JamPsym/letki/archive/hw/ledkiv3.1-baseline-20261015/README.md

# Letki v3.1 — frozen accepted baseline

The user accepted this design as v3.1 on 15 October 2026.
Read [the snapshot record](BASELINE.txt) and [exact identities](baseline.json).
Native CAD and local libraries/models are preserved here; the checked package
is under `exports/prototype/`. Physical qualification remains pending.

Continue human/agent work in the [canonical project](../../../hw/ledkiv3.1/README.md).
This directory is a frozen reference. Preserve its sources and generated package.
