JamPsym/letki/archive/hw/ledkiv3.2-unrouted-20261017/README.txt

Saved checked UNROUTED v3.2 checkpoint, 2026-10-17.
Open hw/ledkiv3.2/ledkiv3_2.kicad_pro for potential human routing.
159 footprints,4layers,307opens; no tracks/vias/zones.
All authored CAD/library/model files are preserved. MANIFEST.json binds them.
Copy the complete folder before routing; keep this checkpoint unchanged.
The live agent-routed successor will remain /home/pies/letki/hw/ledkiv3.2/.
This checkpoint is saved disk state, not a capture of unsaved editor changes.
No fabrication or physical qualification is implied.
