JamPsym/letki/archive/hw/ledkiv4-pre-tme-20261012/ARCHIVE.md

# V4 before the TME redesign

Source snapshot taken on 2026-10-12 before the v4.1 iteration. The original
README and local libraries/mechanical models are preserved. File hashes are
in `snapshot-manifest.json`; design, parts and shipping notes are copied beside
the CAD. This was an unfabricated reviewed prototype candidate, not physically
qualified production hardware. Do not port v4.1 changes into this snapshot.
