JamPsym/letki/docs/tme-next-revision-parts.csv

tme_symbol | mpn | role | population | quantity_per_population | package | currency | minimum | multiple | stock_snapshot | source_age | supplier_url | review_note | status
74HCT238D.653 | 74HCT238D,653 | column decoder | TILE | 1 | SO16 1.27mm | USD | 1 | 1 | 2169 | 4 months; catalogue, not live cart | https://www.tme.eu/pl/katalog/dekodery-multipleksery-przelaczniki_113424/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 | Active-high HCT; needs new SO16 footprint. Confirm stock/lead time. TI CD74HCT238M96 is alternative, not priced. | PRELIMINARY_NEW_REVISION_NOT_V4_ORDER
SN74HCT244PWR | SN74HCT244PWR | row source buffer | TILE | 1 | TSSOP20 0.65mm | USD | 1 | 1 | 2919 | 3 months | https://www.tme.eu/en/details/sn74hct244pwr/buffers-transceivers-drivers/texas-instruments/ | Retain v4 driver and 1.2k current budget; 70mA absolute supply rating is not operating target. | PRELIMINARY_NEW_REVISION_NOT_V4_ORDER
74LVC2G34GW.125 | 74LVC2G34GW,125 | UART dual buffer | TILE | 1 | SOT363-2 6 pins 0.65mm | USD | 1 | 1 | 931 | 2 months; Norway locale USD | https://www.tme.eu/no/en/details/74lvc2g34gw.125/buffers-transceivers-drivers/nexperia/74lvc2g34gw-125/ | New footprint; two always-enabled noninverting buffers; 5.5V tolerant inputs, Ioff; verify UART edge rise/fall conditions with series R. | PRELIMINARY_NEW_REVISION_NOT_V4_ORDER
DMG2302UK-7 | DMG2302UK-7 | column sink MOSFET | TILE | 8 | SOT23 G1 S2 D3 | PLN | 1 | 1 | 7155 | 1 day | https://www.tme.eu/pl/details/dmg2302uk-7/tranzystory-z-kanalem-n-smd/diodes-incorporated/ | 120mOhm maximum at Vgs2.5V/25C. Typical gate charge1.4nC; switching/temperature still need prototype measurements. | PRELIMINARY_NEW_REVISION_NOT_V4_ORDER
MIC5504-3.3YM5-TR | MIC5504-3.3YM5-TR | 3.3V regulator | TILE | 1 | SOT23-5 | PLN | 1 | 1 | 8300 | 1 month | https://www.tme.eu/pl/details/mic5504-3.3ym5-tr/stabilizatory-napiecia-nieregulowane-ldo/microchip-technology/ | New footprint:1IN2GND3EN4NC5OUT; tie EN to IN; input2.5-5.5V; effective output capacitance>=1uF; no probe powering of rail. | PRELIMINARY_NEW_REVISION_NOT_V4_ORDER
CC0603KRX7R9BB104 | CC0603KRX7R9BB104 | 100nF bypass | TILE | 4 | 0603 50V X7R 10% | PLN | 1 | 1 | 239302 | today | https://www.tme.eu/pl/details/cc0603krx7r9bb104/kondensatory-mlcc-smd/yageo/ | Same part as v4; add one more for USB head through head_extra quantity. | PRELIMINARY_NEW_REVISION_NOT_V4_ORDER
CL21B475KAFNNNE | CL21B475KAFNNNE | LDO input/output capacitor | TILE | 2 | 0805 4.7uF 25V X7R 10% | PLN | 10 | 1 | 64111 | 1 day | https://www.tme.eu/pl/details/cl21b475kafnnne/kondensatory-mlcc-smd/samsung/ | Manufacturer mass-production status verified; part-specific DC bias/effective capacitance remains a gate. Alternative2.2uF Murata is not included here. | PRELIMINARY_NEW_REVISION_NOT_V4_ORDER
TACT-64K-F | TACT-64K-F | buttons | TILE | 2 | THT 6x6mm | PLN | 10 | 10 | 4740 | 5 months | https://www.tme.eu/pl/details/tact-64k-f/mikroprzelaczniki-tact/ninigi/ | New footprint; keep THT legs outside LED field; confirm actuation access and carrier clearance. SMT B3U-1000P is smaller and more expensive. | PRELIMINARY_NEW_REVISION_NOT_V4_ORDER
SMD0805-1K2-1% | 0805S8F1201T5E | row resistors | TILE | 8 | 0805 1.2k 1% 125mW 100ppm/C | PLN | 100 | 100 | 73080 | 1 week | https://www.tme.eu/pl/details/smd0805-1k2-1%25/rezystory-smd/royalohm/0805s8f1201t5e/ | Cut-tape catalogue symbol; rendered price rounded to0.01PLN. Confirm exact tier totals. Original W-series full-reel listings may have5000-piece minimum. | PRELIMINARY_NEW_REVISION_NOT_V4_ORDER
SMD0805-100K-1% | 0805S8F1003T5E | idle pulls | TILE | 2 | 0805 100k 1% | PLN | 100 | 100 | 1228463 | 1 week | https://www.tme.eu/pl/details/smd0805-100k-1%25/rezystory-smd/royalohm/0805s8f1003t5e/ | Cut-tape catalogue symbol; rendered price rounded to0.01PLN. Confirm exact tier totals. Original W-series full-reel listings may have5000-piece minimum. | PRELIMINARY_NEW_REVISION_NOT_V4_ORDER
SMD0805-2K2-1% | 0805S8F2201T5E | selectable I2C pulls | TILE | 2 | 0805 2.2k 1% | PLN | 100 | 100 | 884087 | 1 week | https://www.tme.eu/pl/details/smd0805-2k2-1%25/rezystory-smd/royalohm/0805s8f2201t5e/ | Cut-tape catalogue symbol; rendered price rounded to0.01PLN. Confirm exact tier totals. Original W-series full-reel listings may have5000-piece minimum. | PRELIMINARY_NEW_REVISION_NOT_V4_ORDER
SMD0603-100K-1% | 0603SAF1003T5E | startup pulls | TILE | 13 | 0603 100k 1% | PLN | 100 | 100 | 376386 | 1 month | https://www.tme.eu/pl/details/smd0603-100k-1%25/rezystory-smd/royalohm/0603saf1003t5e/ | Cut-tape catalogue symbol; rendered price rounded to0.01PLN. Confirm exact tier totals. Original W-series full-reel listings may have5000-piece minimum. | PRELIMINARY_NEW_REVISION_NOT_V4_ORDER
SMD0603-2K2-1% | 0603SAF2201T5E | UART series resistors | TILE | 2 | 0603 2.2k 1% | PLN | 100 | 100 | 586191 | 1 month | https://www.tme.eu/pl/details/smd0603-2k2-1%25/rezystory-smd/royalohm/0603saf2201t5e/ | Cut-tape catalogue symbol; rendered price rounded to0.01PLN. Confirm exact tier totals. Original W-series full-reel listings may have5000-piece minimum. | PRELIMINARY_NEW_REVISION_NOT_V4_ORDER
SMD0603-5K1-1% | 0603SAF5101T5E | USB CC pulls | HEAD_ONLY | 2 | 0603 5.1k 1% | PLN | 100 | 100 |  | 8 months; stock unconfirmed | https://www.tme.eu/pl/details/smd0603-5k1-1%25/rezystory-smd/royalohm/0603saf5101t5e/ | Cut-tape catalogue symbol; rendered price rounded to0.01PLN. Confirm exact tier totals. Original W-series full-reel listings may have5000-piece minimum. | PRELIMINARY_NEW_REVISION_NOT_V4_ORDER
SMD0603-33K-1% | 0603SAF3302T5E | USB current limit resistor | HEAD_ONLY | 1 | 0603 33k 1% 100ppm/C | PLN | 100 | 100 | 103499 | 2 months | https://www.tme.eu/pl/details/smd0603-33k-1%25/rezystory-smd/royalohm/0603saf3302t5e/ | Cut-tape catalogue symbol; rendered price rounded to0.01PLN. Confirm exact tier totals. Original W-series full-reel listings may have5000-piece minimum. | PRELIMINARY_NEW_REVISION_NOT_V4_ORDER
USB4216-03-A | USB4216-03-A | USB-C head connector | HEAD_ONLY | 1 | 16pin SMT; new manufacturer footprint | PLN | 1 | 1 | 1374 | 1 month | https://www.tme.eu/pl/details/usb4216-03-a/zlacza-usb-i-ieee1394/gct/ | New lands/anchors/edge clearance; independent5.1k on each CC; no USB data or PD. One powered USB head per chain. | PRELIMINARY_NEW_REVISION_NOT_V4_ORDER
TPS2553DBVR | TPS2553DBVR | USB input current limiter | HEAD_ONLY | 1 | SOT23-6 | PLN | 1 | 1 | 5 | 1 week | https://www.tme.eu/pl/details/tps2553dbvr/power-switches-uklady-scalone/texas-instruments/ | Retain v4 head scheme and33k current setting; -1 is not automatic substitute. One head per estimate, not a20-board power qualification. | PRELIMINARY_NEW_REVISION_NOT_V4_ORDER
MX-53047-0310 | 530470310 | optional SWIO header | OPTIONAL_PER_TILE | 1 | PicoBlade3pin vertical THT | PLN | 1 | 1 | 2345 | 1 month | https://www.tme.eu/pl/details/mx-53047-0310/zlacza-sygnalowe-raster-1-25mm/molex/53047-0310/ | Optional one/tile; retain bare pads. REF3.3V is not programmer power input. Cable priced separately. | PRELIMINARY_NEW_REVISION_NOT_V4_ORDER
