JamPsym/letki/hw/ledkiv2/dyfuzor/PCB ledkiv2.FCStd

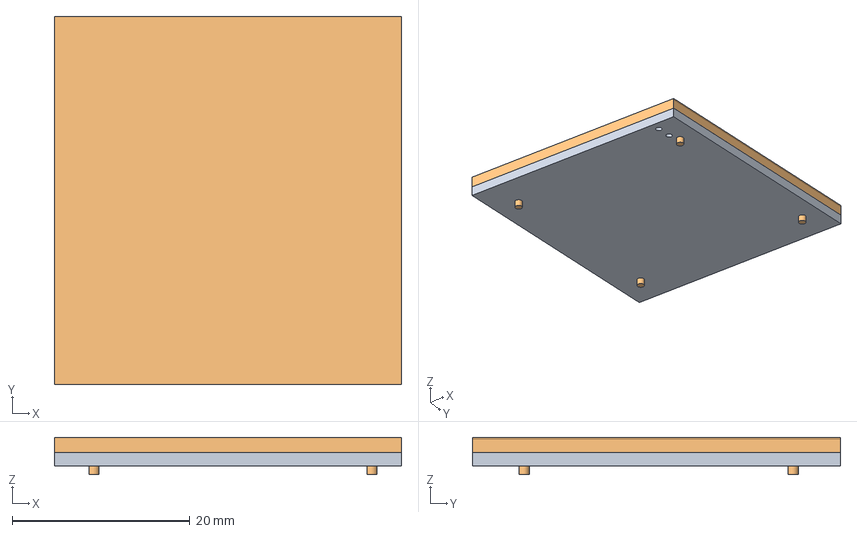
[picture p1: CAD file, 2025-11-01]
hw/ledkiv2/dyfuzor/PCB ledkiv2.FCStd
39.0 x 41.4 x 4.20 mm
LED_0805_2012Metric
LED_0805_2012Metric001
LED_0805_2012Metric002
LED_0805_2012Metric003
LED_0805_2012Metric004
LED_0805_2012Metric005
LED_0805_2012Metric006
LED_0805_2012Metric007
LED_0805_2012Metric008
LED_0805_2012Metric009
LED_0805_2012Metric010
LED_0805_2012Metric011
LED_0805_2012Metric012
LED_0805_2012Metric013
LED_0805_2012Metric014
LED_0805_2012Metric015
LED_0805_2012Metric016
LED_0805_2012Metric017
LED_0805_2012Metric018
LED_0805_2012Metric019
LED_0805_2012Metric020
LED_0805_2012Metric021
LED_0805_2012Metric022
LED_0805_2012Metric023
LED_0805_2012Metric024
LED_0805_2012Metric025
LED_0805_2012Metric026
LED_0805_2012Metric027
LED_0805_2012Metric028
LED_0805_2012Metric029
LED_0805_2012Metric030
LED_0805_2012Metric031
LED_0805_2012Metric032
LED_0805_2012Metric033
LED_0805_2012Metric034
LED_0805_2012Metric035
LED_0805_2012Metric036
LED_0805_2012Metric037
LED_0805_2012Metric038
LED_0805_2012Metric039
LED_0805_2012Metric040
LED_0805_2012Metric041
LED_0805_2012Metric042
LED_0805_2012Metric043
LED_0805_2012Metric044
LED_0805_2012Metric045
LED_0805_2012Metric046
LED_0805_2012Metric047
LED_0805_2012Metric048
LED_0805_2012Metric049
LED_0805_2012Metric050
LED_0805_2012Metric051
LED_0805_2012Metric052
LED_0805_2012Metric053
LED_0805_2012Metric054
LED_0805_2012Metric055
LED_0805_2012Metric056
LED_0805_2012Metric057
LED_0805_2012Metric058
LED_0805_2012Metric059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
