JamPsym/letki/hw/ledkiv4/mechanics/letkiv4-mechanics-1-tiles.FCStd

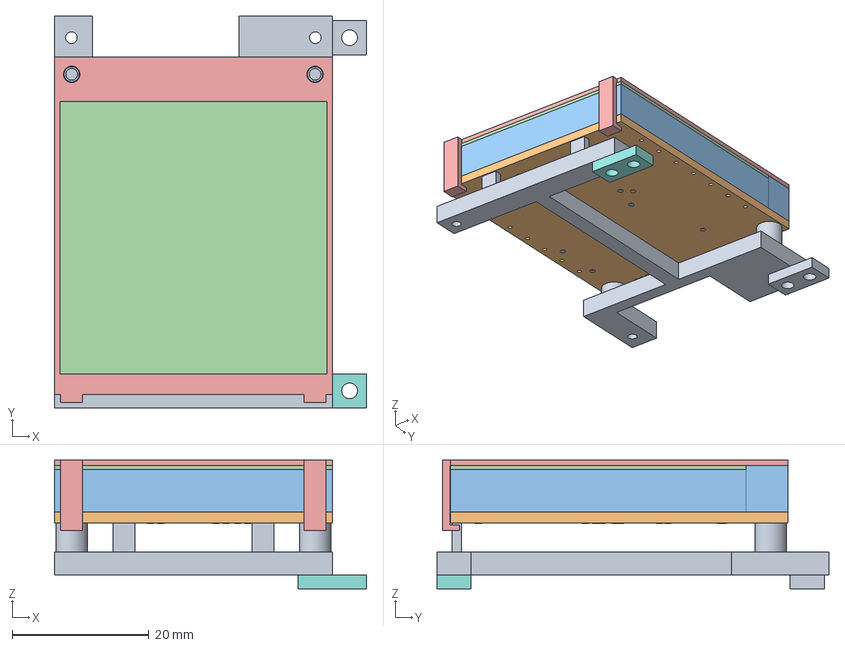
[picture p3: CAD file, 2026-10-18]
hw/ledkiv4/mechanics/letkiv4-mechanics-1-tiles.FCStd
45.6 x 57.3 x 18.8 mm
Carrier
PCB1
OpaqueGrid1
TranslucentFace1
FrontBezel1
TP1_Tile1
TP2_Tile1
TP3_Tile1
TP4_Tile1
TP5_Tile1
TP6_Tile1
TP7_Tile1
TP8_Tile1
TP9_Tile1
TP10_Tile1
SpliceTop
SpliceBottom
