JamPsym/letki/archive/hw/ledkiv4-flat-pads-20261012/mechanics/letkiv4-mechanics-4-tiles.FCStd

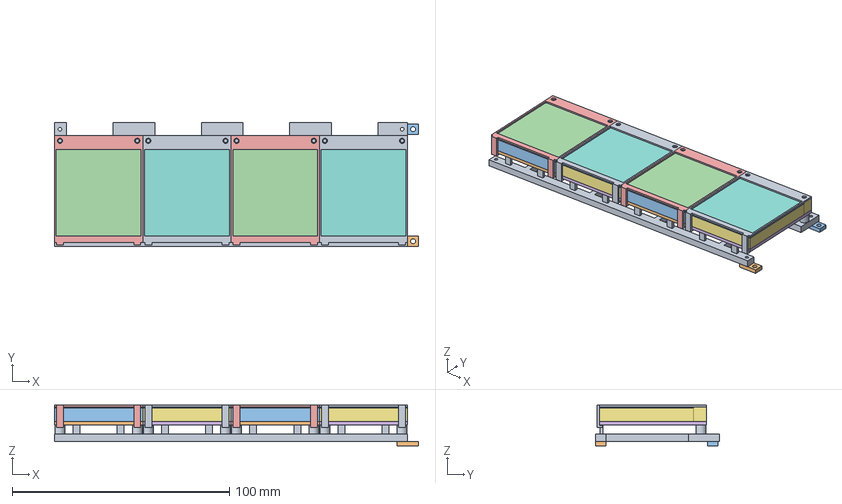
[picture p5: CAD file, 2026-10-18, an earlier design]
archive/hw/ledkiv4-flat-pads-20261012/mechanics/letkiv4-mechanics-4-tiles.FCStd
167.6 x 57.3 x 18.8 mm
Carrier
PCB1
OpaqueGrid1
TranslucentFace1
FrontBezel1
PCB2
OpaqueGrid2
TranslucentFace2
FrontBezel2
PCB3
OpaqueGrid3
TranslucentFace3
FrontBezel3
PCB4
OpaqueGrid4
TranslucentFace4
FrontBezel4
SpliceTop
SpliceBottom
