JamPsym/letki/archive/hw/ledkiv4-optical-initial/letkiv4-optical-prototype.FCStd

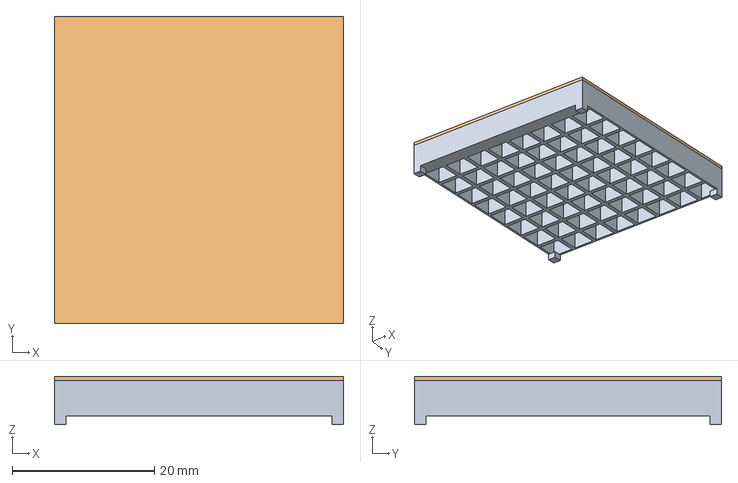
[picture p6: CAD file, 2026-10-18, an earlier design]
archive/hw/ledkiv4-optical-initial/letkiv4-optical-prototype.FCStd
40.6 x 43.2 x 6.80 mm
OpaqueGrid
TranslucentFace
