JamPsym/letki/archive/hw/ledkiv4-pre-tme-20261012/mechanics/letkiv4-mechanics-4-tiles.FCStd

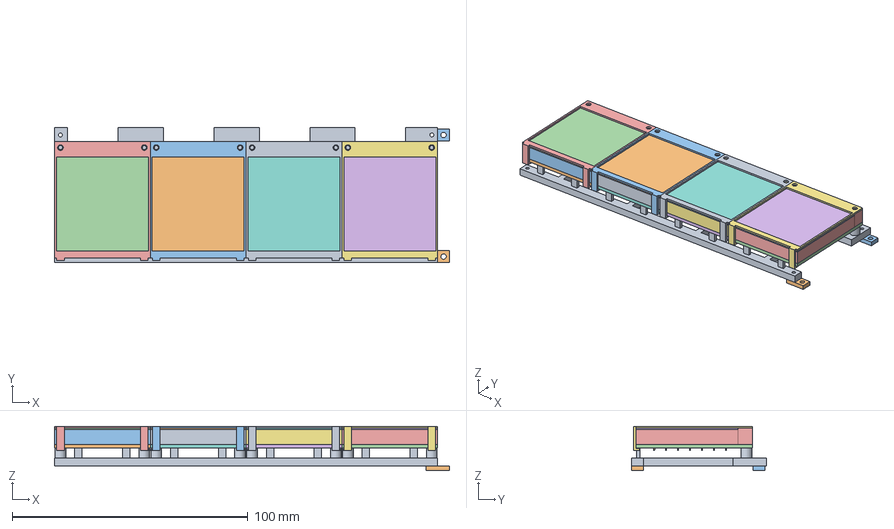
[picture p7: CAD file, 2026-10-18, an earlier design]
archive/hw/ledkiv4-pre-tme-20261012/mechanics/letkiv4-mechanics-4-tiles.FCStd
167.6 x 57.3 x 18.8 mm
Carrier
PCB1
OpaqueGrid1
TranslucentFace1
FrontBezel1
TP1_Tile1
TP2_Tile1
TP3_Tile1
TP4_Tile1
TP5_Tile1
TP6_Tile1
TP7_Tile1
TP8_Tile1
TP9_Tile1
TP10_Tile1
PCB2
OpaqueGrid2
TranslucentFace2
FrontBezel2
TP1_Tile2
TP2_Tile2
TP3_Tile2
TP4_Tile2
TP5_Tile2
TP6_Tile2
TP7_Tile2
TP8_Tile2
TP9_Tile2
TP10_Tile2
PCB3
OpaqueGrid3
TranslucentFace3
FrontBezel3
TP1_Tile3
TP2_Tile3
TP3_Tile3
TP4_Tile3
TP5_Tile3
TP6_Tile3
TP7_Tile3
TP8_Tile3
TP9_Tile3
TP10_Tile3
PCB4
OpaqueGrid4
TranslucentFace4
FrontBezel4
TP1_Tile4
TP2_Tile4
TP3_Tile4
TP4_Tile4
TP5_Tile4
TP6_Tile4
TP7_Tile4
TP8_Tile4
TP9_Tile4
TP10_Tile4
SpliceTop
SpliceBottom
WireBridge1_1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
