JamPsym/letki/(list of files, cad)

Other CAD files:
archive/hw/ledkiv4-offset-wire-20261012/mechanics/letkiv4-mechanics-4-tiles.FCStd
archive/hw/ledkiv4.1-purchase-20261013/mechanics/letkiv4_1-mechanics-4-tiles.FCStd
archive/hw/ledkiv4-flat-pads-20261012/mechanics/letkiv4-mechanics-1-tiles.FCStd
archive/hw/ledkiv4-offset-wire-20261012/mechanics/letkiv4-mechanics-1-tiles.FCStd
archive/hw/ledkiv4.1-purchase-20261013/mechanics/letkiv4_1-mechanics-1-tiles.FCStd
