JamPsym/letki/docs/research/v3_1/ASSEMBLY-HANDOFF.txt

V3 current-test flash completed by the assembly/testing session on 2026-10-14.
Board: second v3, UUID d7-6e-ab-cd-41-3a-bd-ff.
Image: your build/v3-current-demo/letki.bin; 5240 bytes.
SHA256: 042b5de78f28db03d02f02ba9768acc552b9705980ae95242a5d0fcfe65ece30.
Two matching full-flash backups; all image bytes verified; option bytes preserved.
SWIO startup/status/blank/R1 restore passed. Final selection R1/S1 bottom-left
pixel, brightness 100, nominal scan duty 10%.
Actual current, supply, waveform and visual observation remain pending.
Evidence: /home/pies/letki/build/board-readback/current-demo-20261014/summary.json.
Do not infer measured current from host tests or the successful flash.

User-reported measurements: 0.067 V across R1 and 3.312 V supply (interpreted
in requested order), UNI-T UT61B DC voltage. Using nominal R1=51 ohm gives
1.31 mA average and estimated 13.1 mA during nominal 10%-duty pulses.
Actual resistance and waveform were not measured; mean-reading assumption
remains. This tests a single pixel, not a full-column load. Earlier mV-range
disagreement is unresolved. Evidence: /home/pies/letki/build/board-readback/current-demo-20261014/user-current-measurement.json

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

### Two-board UART-chain setup: left board flashed (2026-10-14)

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

## Physical two-board UART-chain result (2026-10-14)

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

## Physical two-board I2C result (2026-10-14)

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

## Two-board ping-pong demo (2026-10-14)

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

## Native C strip renderer (2026-10-14)

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

## Standard two-board text candidate and preview (2026-10-14)

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

## Standard text right receiver flashed (2026-10-14)

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

## Standard text pair programmed and tested (2026-10-14)

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
