JamPsym/letki/hw/ledkiv3.2/ledkiv3_2.kicad_pcb

## KiCad design hw/ledkiv3.2/ledkiv3_2.kicad_pcb (2026-10-18)

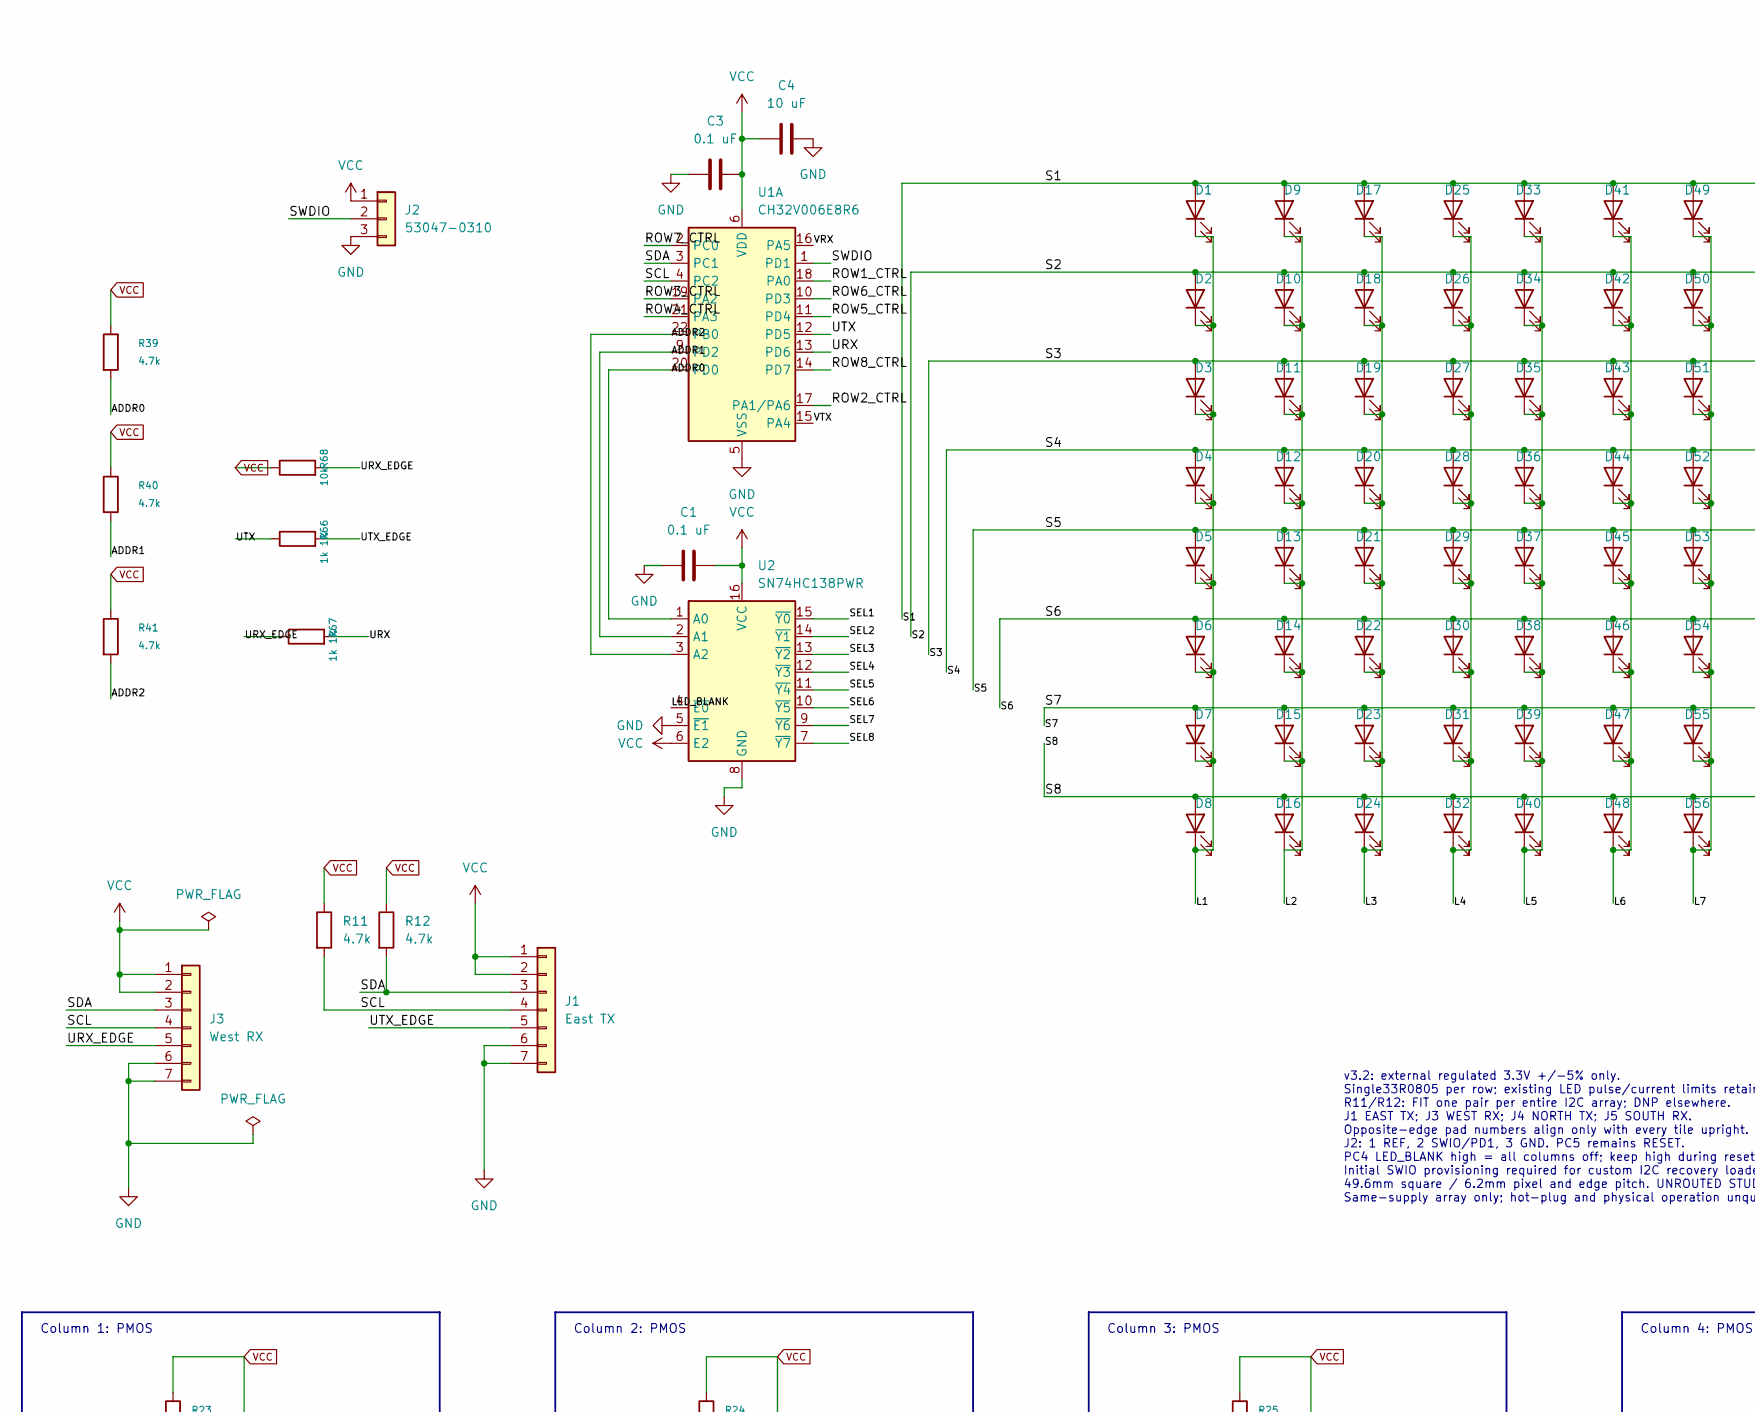
[picture p8: schematic ledkiv3_2.kicad_sch, Letki v3.2 — QSOP24 rectangular tile, part in row 1, column 1]

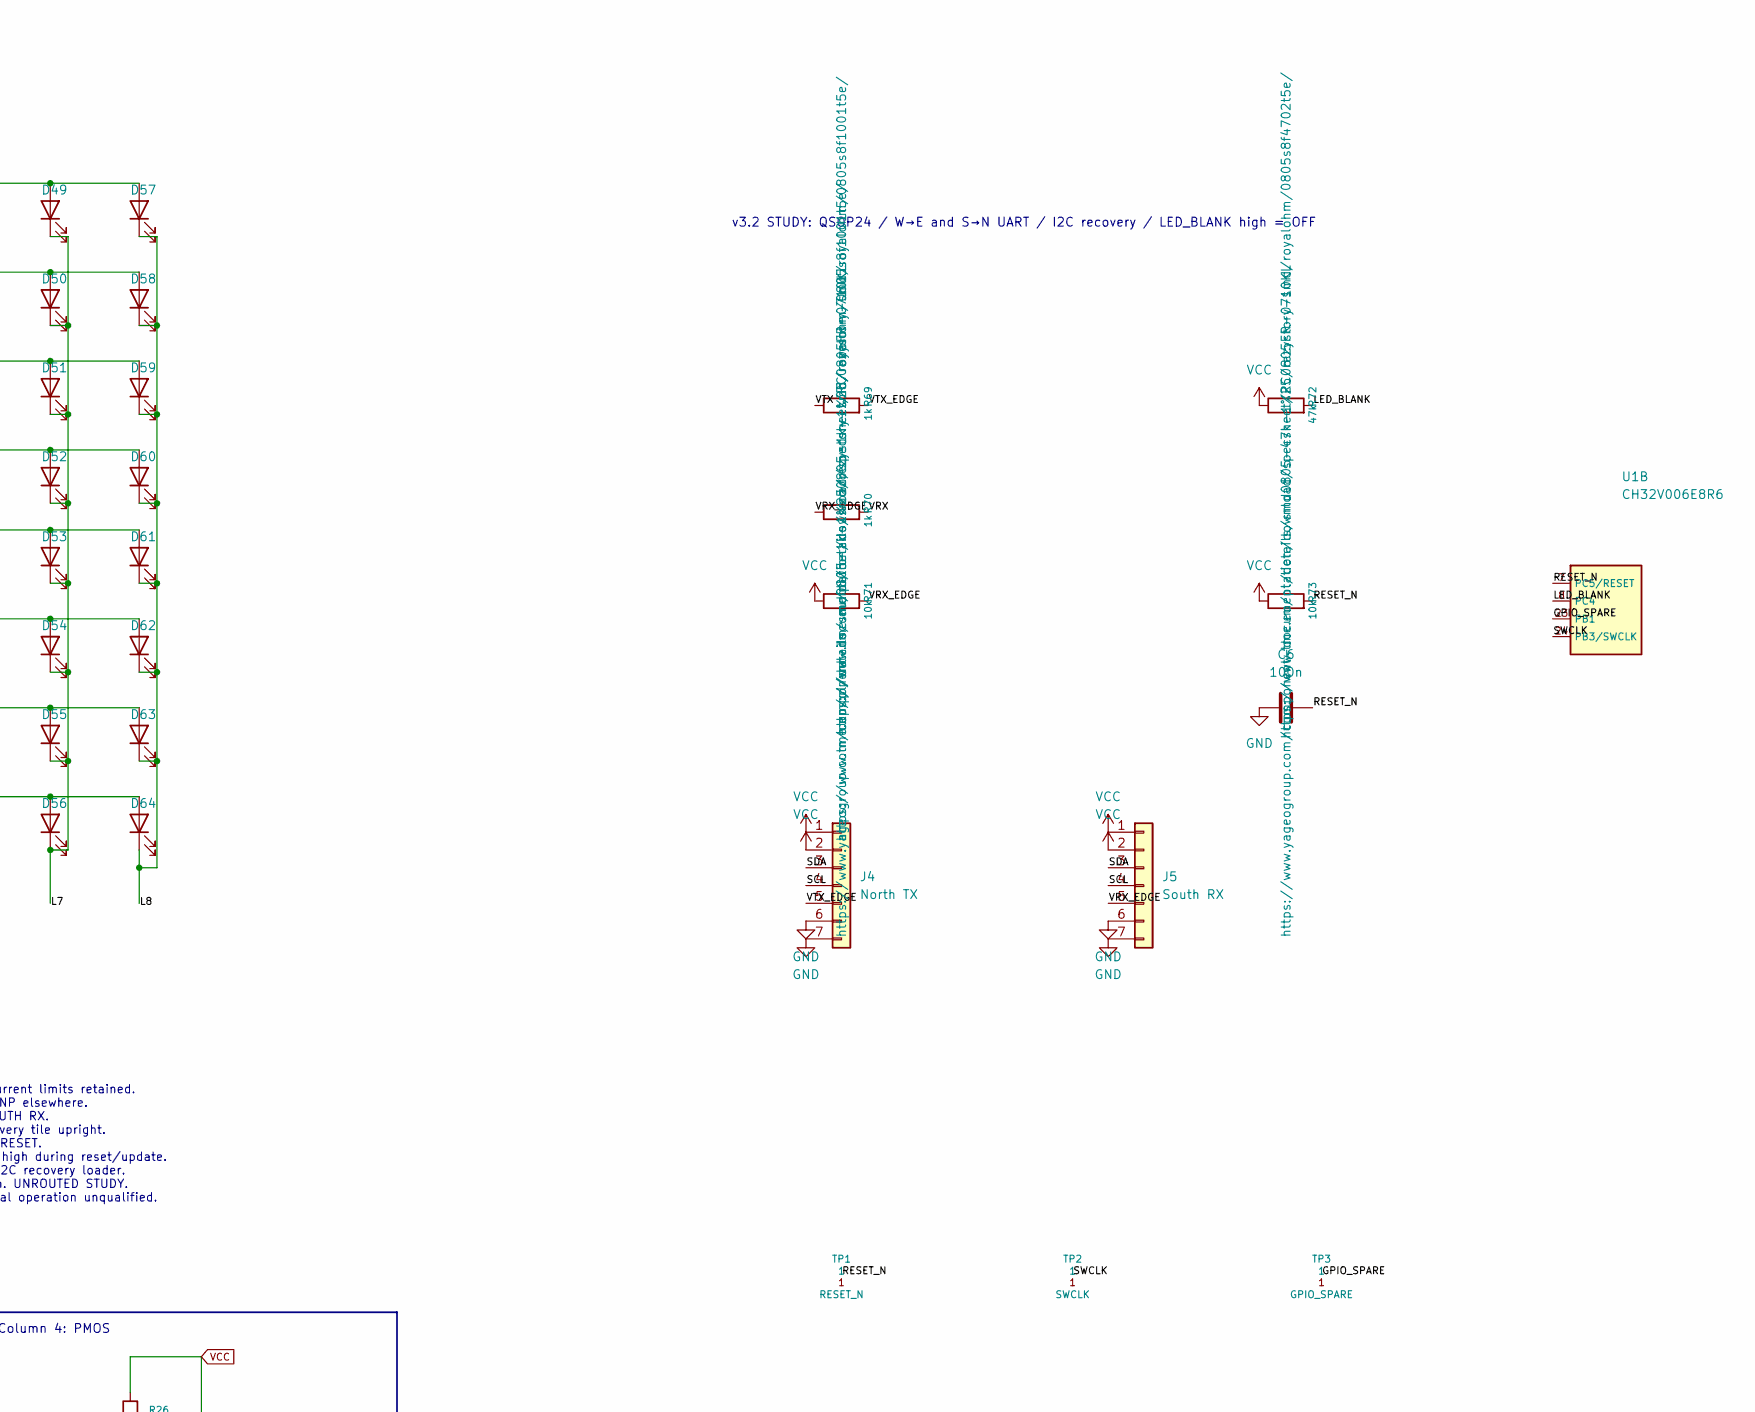
[picture p9: schematic ledkiv3_2.kicad_sch, Letki v3.2 — QSOP24 rectangular tile, part in row 1, column 2]

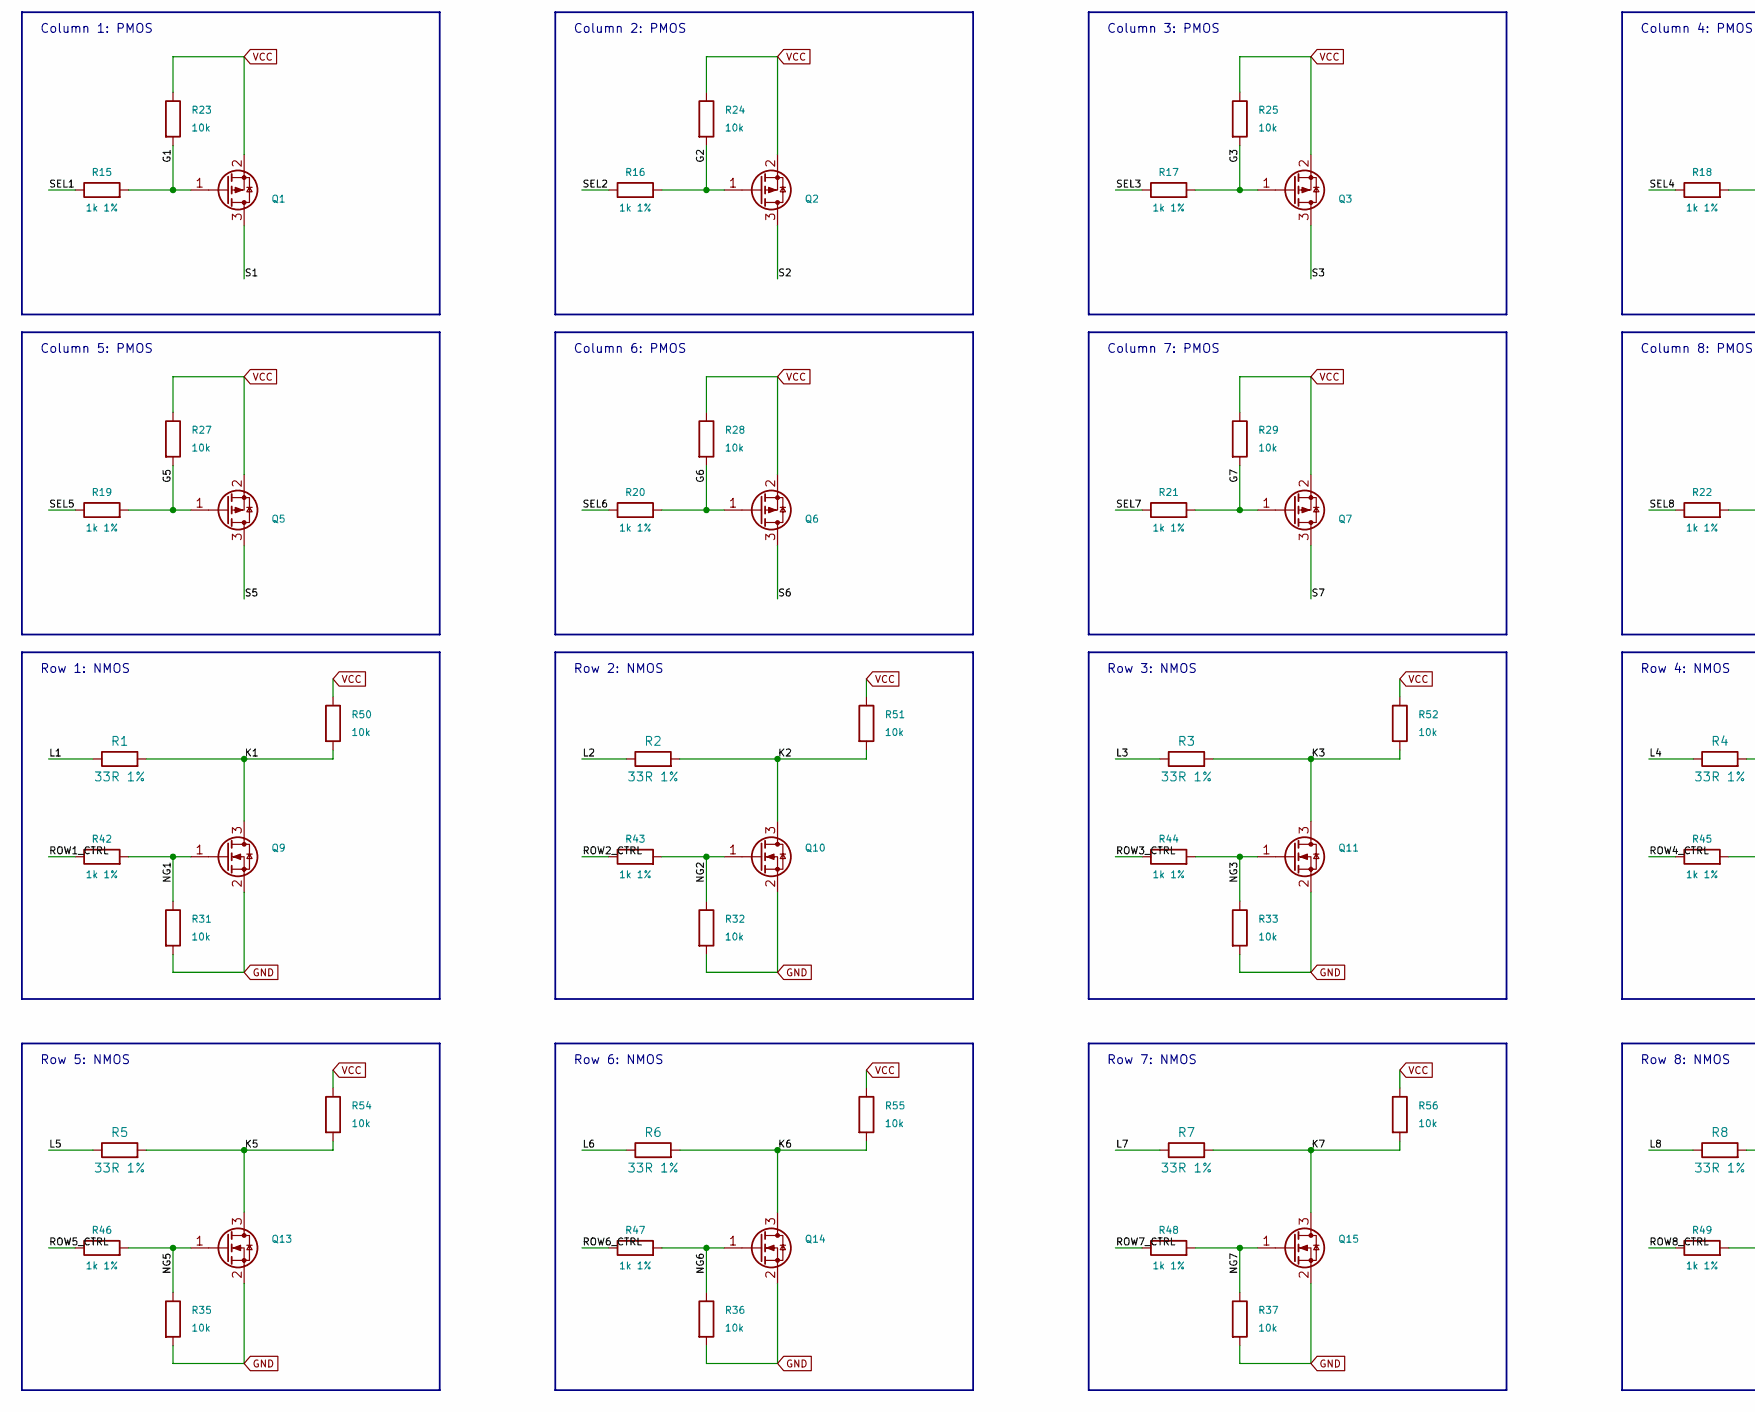
[picture p10: schematic ledkiv3_2.kicad_sch, Letki v3.2 — QSOP24 rectangular tile, part in row 2, column 1]

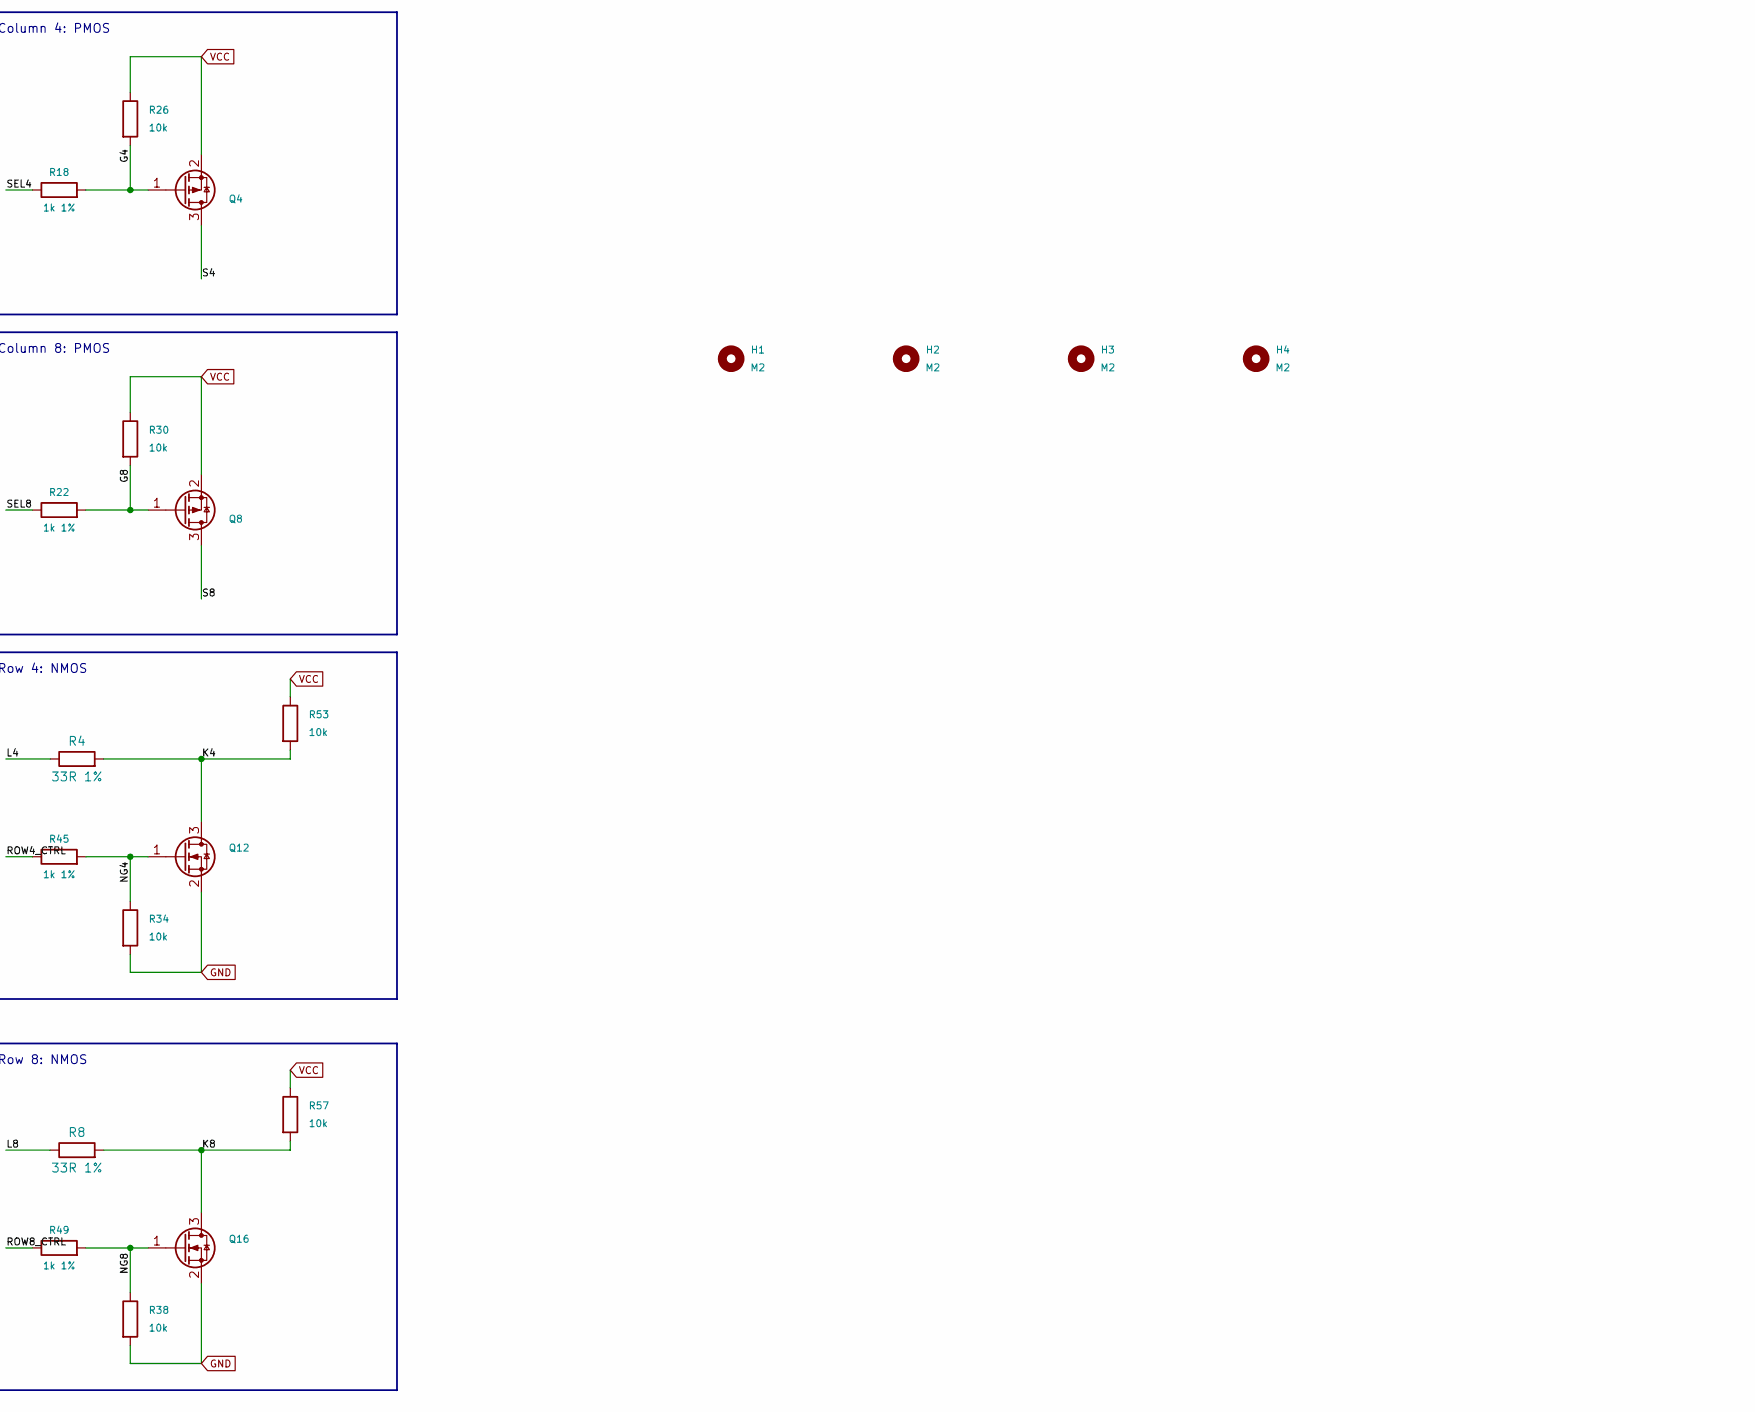
[picture p11: schematic ledkiv3_2.kicad_sch, Letki v3.2 — QSOP24 rectangular tile, part in row 2, column 2]

Parts:
C1, C3: 0.1 uF; C_0805_2012Metric_Pad1.18x1.45mm_HandSolder; MPN C0805B104K500NT
C4: 10 uF; C_0805_2012Metric_Pad1.18x1.45mm_HandSolder; MPN CL21A106KAYNNNE
C6: 100n; C_0805_2012Metric_Pad1.18x1.45mm_HandSolder; MPN C0805B104K500NT
D1, D2, D3, D4, D5, D6, D7, D8, D9, D10, D11, D12, D13, D14, D15, D16, D17, D18, D19, D20, D21, D22, D23, D24, D25, D26, D27, D28, D29, D30, D31, D32, D33, D34, D35, D36, D37, D38, D39, D40, D41, D42, D43, D44, D45, D46, D47, D48, D49, D50, D51, D52, D53, D54, D55, D56, D57, D58, D59, D60, D61, D62, D63, D64: XL-2012UOC; LED_0805_2012Metric_LetkiFab; MPN XL-2012UOC
H1, H2, H3, H4: M2; MountingHole_2.2mm_M2_LetkiFab
J1: East TX; EdgeWire_1x07_P6.2mm_D0.8mm
J2: 53047-0310; Molex_PicoBlade_53047-0310_1x03_P1.25mm_Vertical_SWIO_Letki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; MPN 530470310
J3: West RX; EdgeWire_1x07_P6.2mm_D0.8mm
J4: North TX; EdgeWire_1x07_P6.2mm_D0.8mm
J5: South RX; EdgeWire_1x07_P6.2mm_D0.8mm
Q1, Q2, Q3, Q4, Q5, Q6, Q7, Q8: AO3415A; SOT-23; MPN AO3415A
Q9, Q10, Q11, Q12, Q13, Q14, Q15, Q16: DMN2056U-7; SOT-23; MPN DMN2056U-7
R1, R2, R3, R4, R5, R6, R7, R8: 33R 1%; R_0805_2012Metric_Pad1.20x1.40mm_HandSolder; MPN 0805S8F330JT5E
R11, R12, R39, R40, R41: 4.7k; R_0805_2012Metric_Pad1.20x1.40mm_HandSolder; MPN 0805W8J0472T5E
R15, R16, R17, R18, R19, R20, R21, R22, R42, R43, R44, R45, R46, R47, R48, R49: 1k 1%; R_0603_1608Metric_Pad0.98x0.95mm_HandSolder; MPN 0603SAF1001T5E
R23, R24, R25, R26, R27, R28, R29, R30, R31, R32, R33, R34, R35, R36, R37, R38, R50, R51, R52, R53, R54, R55, R56, R57: 10k; R_0603_1608Metric_Pad0.98x0.95mm_HandSolder; MPN 0603SAF1002T5E
R66, R67: 1k 1%; R_0805_2012Metric_Pad1.20x1.40mm_HandSolder; MPN 0805S8F1001T5E
R68, R71, R73: 10k; R_0805_2012Metric_Pad1.20x1.40mm_HandSolder; MPN RC0805FR-0710KL
R69, R70: 1k; R_0805_2012Metric_Pad1.20x1.40mm_HandSolder; MPN 0805S8F1001T5E
R72: 47k; R_0805_2012Metric_Pad1.20x1.40mm_HandSolder; MPN 0805S8F4702T5E
TP1: RESET_N; TestPoint_1.5mm
TP2: SWCLK; TestPoint_1.5mm
TP3: GPIO_SPARE; TestPoint_1.5mm
U1: CH32V006E8R6; QSOP-24_3.9x8.7mm_P0.635mm; MPN CH32V006E8R6
U2: SN74HC138PWR; TSSOP-16_4.4x5mm_P0.65mm; MPN SN74HC138PWR

Connections:
/ADDR0: R39.2, U1.20 (PD0), U2.1 (A0)
/ADDR1: R40.2, U1.9 (PD2), U2.2 (A1)
/ADDR2: R41.2, U1.22 (PB0), U2.3 (A2)
/G1: Q1.1 (G), R15.2, R23.2
/G2: Q2.1 (G), R16.2, R24.2
/G3: Q3.1 (G), R17.2, R25.2
/G4: Q4.1 (G), R18.2, R26.2
/G5: Q5.1 (G), R19.2, R27.2
/G6: Q6.1 (G), R20.2, R28.2
/G7: Q7.1 (G), R21.2, R29.2
/G8: Q8.1 (G), R22.2, R30.2
/GPIO_SPARE: TP3.1, U1.23 (PB1)
/K1: Q9.3 (D), R1.2, R50.2
/K2: Q10.3 (D), R2.2, R51.2
/K3: Q11.3 (D), R3.2, R52.2
/K4: Q12.3 (D), R4.2, R53.2
/K5: Q13.3 (D), R5.2, R54.2
/K6: Q14.3 (D), R6.2, R55.2
/K7: Q15.3 (D), R7.2, R56.2
/K8: Q16.3 (D), R8.2, R57.2
/L1: D1.1 (K), D2.1 (K), D3.1 (K), D4.1 (K), D5.1 (K), D6.1 (K), D7.1 (K), D8.1 (K), R1.1
/L2: D9.1 (K), D10.1 (K), D11.1 (K), D12.1 (K), D13.1 (K), D14.1 (K), D15.1 (K), D16.1 (K), R2.1
/L3: D17.1 (K), D18.1 (K), D19.1 (K), D20.1 (K), D21.1 (K), D22.1 (K), D23.1 (K), D24.1 (K), R3.1
/L4: D25.1 (K), D26.1 (K), D27.1 (K), D28.1 (K), D29.1 (K), D30.1 (K), D31.1 (K), D32.1 (K), R4.1
/L5: D33.1 (K), D34.1 (K), D35.1 (K), D36.1 (K), D37.1 (K), D38.1 (K), D39.1 (K), D40.1 (K), R5.1
/L6: D41.1 (K), D42.1 (K), D43.1 (K), D44.1 (K), D45.1 (K), D46.1 (K), D47.1 (K), D48.1 (K), R6.1
/L7: D49.1 (K), D50.1 (K), D51.1 (K), D52.1 (K), D53.1 (K), D54.1 (K), D55.1 (K), D56.1 (K), R7.1
/L8: D57.1 (K), D58.1 (K), D59.1 (K), D60.1 (K), D61.1 (K), D62.1 (K), D63.1 (K), D64.1 (K), R8.1
/LED_BLANK: R72.2, U1.8 (PC4), U2.4 (~E0)
/NG1: Q9.1 (G), R31.1, R42.2
/NG2: Q10.1 (G), R32.1, R43.2
/NG3: Q11.1 (G), R33.1, R44.2
/NG4: Q12.1 (G), R34.1, R45.2
/NG5: Q13.1 (G), R35.1, R46.2
/NG6: Q14.1 (G), R36.1, R47.2
/NG7: Q15.1 (G), R37.1, R48.2
/NG8: Q16.1 (G), R38.1, R49.2
/RESET_N: C6.2, R73.2, TP1.1, U1.7 (PC5/RESET)
/ROW1_CTRL: R42.1, U1.18 (PA0)
/ROW2_CTRL: R43.1, U1.17 (PA1/PA6)
/ROW3_CTRL: R44.1, U1.19 (PA2)
/ROW4_CTRL: R45.1, U1.21 (PA3)
/ROW5_CTRL: R46.1, U1.11 (PD4)
/ROW6_CTRL: R47.1, U1.10 (PD3)
/ROW7_CTRL: R48.1, U1.2 (PC0)
/ROW8_CTRL: R49.1, U1.14 (PD7)
/S1: D1.2 (A), D9.2 (A), D17.2 (A), D25.2 (A), D33.2 (A), D41.2 (A), D49.2 (A), D57.2 (A), Q1.3 (D)
/S2: D2.2 (A), D10.2 (A), D18.2 (A), D26.2 (A), D34.2 (A), D42.2 (A), D50.2 (A), D58.2 (A), Q2.3 (D)
/S3: D3.2 (A), D11.2 (A), D19.2 (A), D27.2 (A), D35.2 (A), D43.2 (A), D51.2 (A), D59.2 (A), Q3.3 (D)
/S4: D4.2 (A), D12.2 (A), D20.2 (A), D28.2 (A), D36.2 (A), D44.2 (A), D52.2 (A), D60.2 (A), Q4.3 (D)
/S5: D5.2 (A), D13.2 (A), D21.2 (A), D29.2 (A), D37.2 (A), D45.2 (A), D53.2 (A), D61.2 (A), Q5.3 (D)
/S6: D6.2 (A), D14.2 (A), D22.2 (A), D30.2 (A), D38.2 (A), D46.2 (A), D54.2 (A), D62.2 (A), Q6.3 (D)
/S7: D7.2 (A), D15.2 (A), D23.2 (A), D31.2 (A), D39.2 (A), D47.2 (A), D55.2 (A), D63.2 (A), Q7.3 (D)
/S8: D8.2 (A), D16.2 (A), D24.2 (A), D32.2 (A), D40.2 (A), D48.2 (A), D56.2 (A), D64.2 (A), Q8.3 (D)
/SCL: J1.4, J3.4, J4.4, J5.4, R11.2, U1.4 (PC2)
/SDA: J1.3, J3.3, J4.3, J5.3, R12.2, U1.3 (PC1)
/SEL1: R15.1, U2.15 (~Y0)
/SEL2: R16.1, U2.14 (~Y1)
/SEL3: R17.1, U2.13 (~Y2)
/SEL4: R18.1, U2.12 (~Y3)
/SEL5: R19.1, U2.11 (~Y4)
/SEL6: R20.1, U2.10 (~Y5)
/SEL7: R21.1, U2.9 (~Y6)
/SEL8: R22.1, U2.7 (~Y7)
/SWCLK: TP2.1, U1.24 (PB3/SWCLK)
/SWDIO: J2.2, U1.1 (PD1)
/URX: R67.2, U1.13 (PD6)
/URX_EDGE: J3.5, R67.1, R68.2
/UTX: R66.1, U1.12 (PD5)
/UTX_EDGE: J1.5, R66.2
/VRX: R70.2, U1.16 (PA5)
/VRX_EDGE: J5.5, R70.1, R71.2
/VTX: R69.1, U1.15 (PA4)
/VTX_EDGE: J4.5, R69.2
GND: C1.1, C3.1, C4.2, C6.1, J1.6, J1.7, J2.3, J3.6, J3.7, J4.6, J4.7, J5.6, J5.7, Q9.2 (S), Q10.2 (S), Q11.2 (S), Q12.2 (S), Q13.2 (S), Q14.2 (S), Q15.2 (S), Q16.2 (S), R31.2, R32.2, R33.2, R34.2, R35.2, R36.2, R37.2, R38.2, U1.5 (VSS), U2.5 (~E1), U2.8 (GND)
VCC: C1.2, C3.2, C4.1, J1.1, J1.2, J2.1, J3.1, J3.2, J4.1, J4.2, J5.1, J5.2, Q1.2 (S), Q2.2 (S), Q3.2 (S), Q4.2 (S), Q5.2 (S), Q6.2 (S), Q7.2 (S), Q8.2 (S), R11.1, R12.1, R23.1, R24.1, R25.1, R26.1, R27.1, R28.1, R29.1, R30.1, R39.1, R40.1, R41.1, R50.1, R51.1, R52.1, R53.1, R54.1, R55.1, R56.1, R57.1, R68.1, R71.1, R72.1, R73.1, U1.6 (VDD), U2.6 (E2), U2.16 (VCC)

Notes on the sheet:
v3.2: external regulated 3.3V +/-5% only. Single33R0805 per row; existing LED pulse/current limits retained. R11/R12: FIT one pair per entire I2C array; DNP elsewhere. J1 EAST TX; J3 WEST RX; J4 NORTH TX; J5 SOUTH RX. Opposite-edge pad numbers align only with every tile upright. J2: 1 REF, 2 SWIO/P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
Column 8: PMOS
Column 6: PMOS
Column 4: PMOS
Column 2: PMOS
Row 6: NMOS
Row 2: NMOS
Column 7: PMOS
Row 5: NMOS
Row 7: NMOS
Row 1: NMOS
Column 5: PMOS
Column 3: PMOS
Row 8: NMOS
Row 4: NMOS
Column 1: PMOS
Row 3: NMOS
v3.2 STUDY: QSOP24 / W→E and S→N UART / I2C recovery / LED_BLANK high = OFF

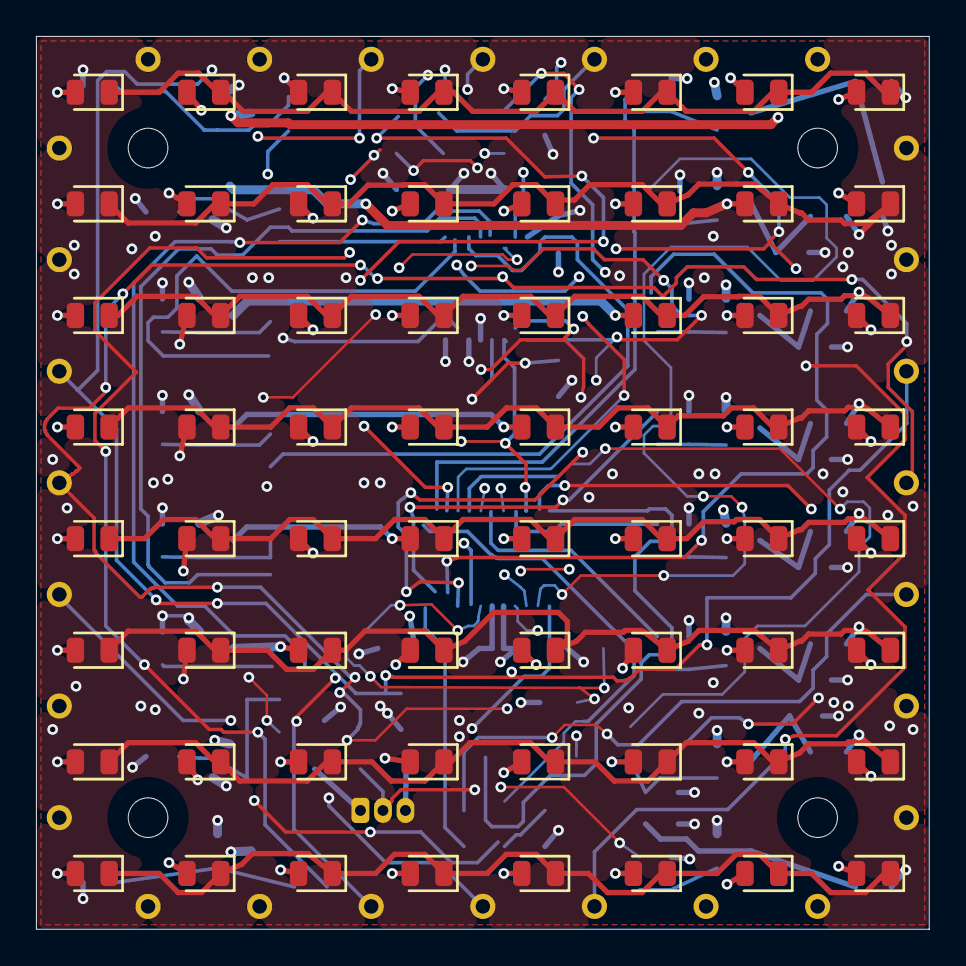
[picture p12: board ledkiv3_2.kicad_pcb from above]

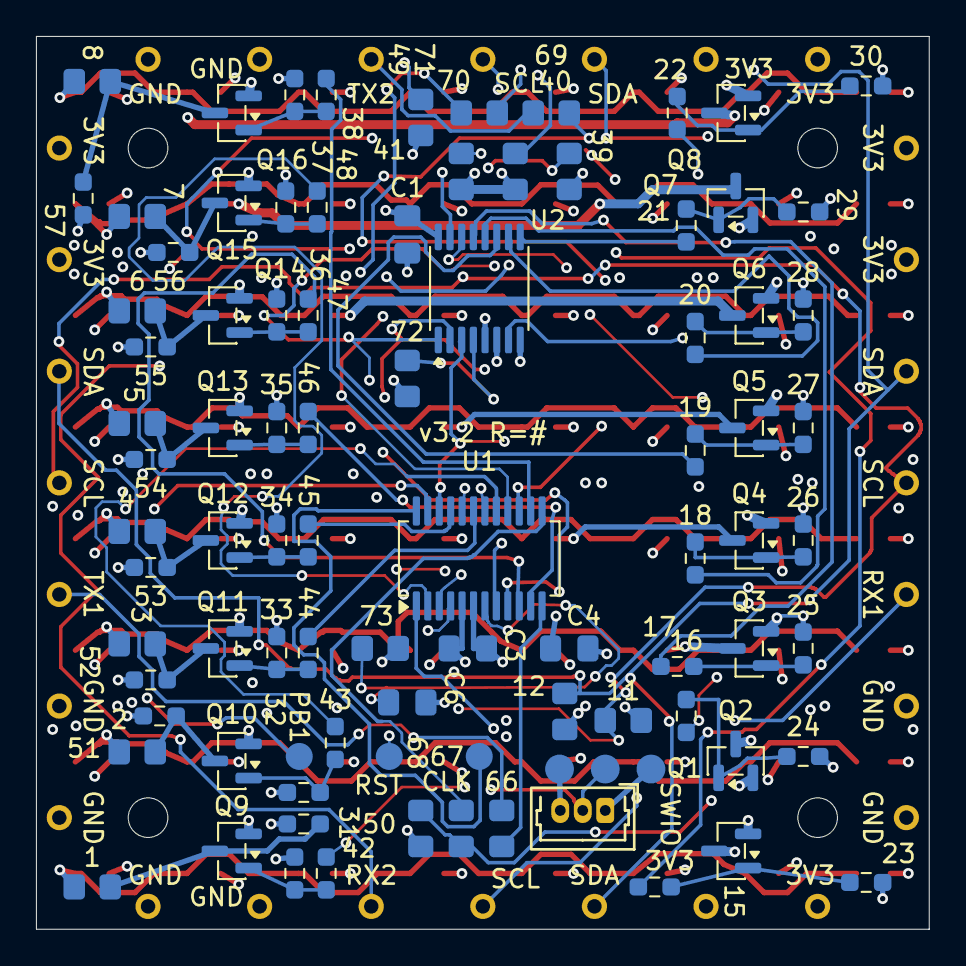
[picture p13: board ledkiv3_2.kicad_pcb from below]

Board: 4 copper layers, 49.6 x 49.6 mm, 159 parts (91 on the bottom side), 76 nets.
