JamPsym/letki/hw/ledki8x8/ledki8x8.kicad_pcb

## KiCad design hw/ledki8x8/ledki8x8.kicad_pcb (2025-10-16)

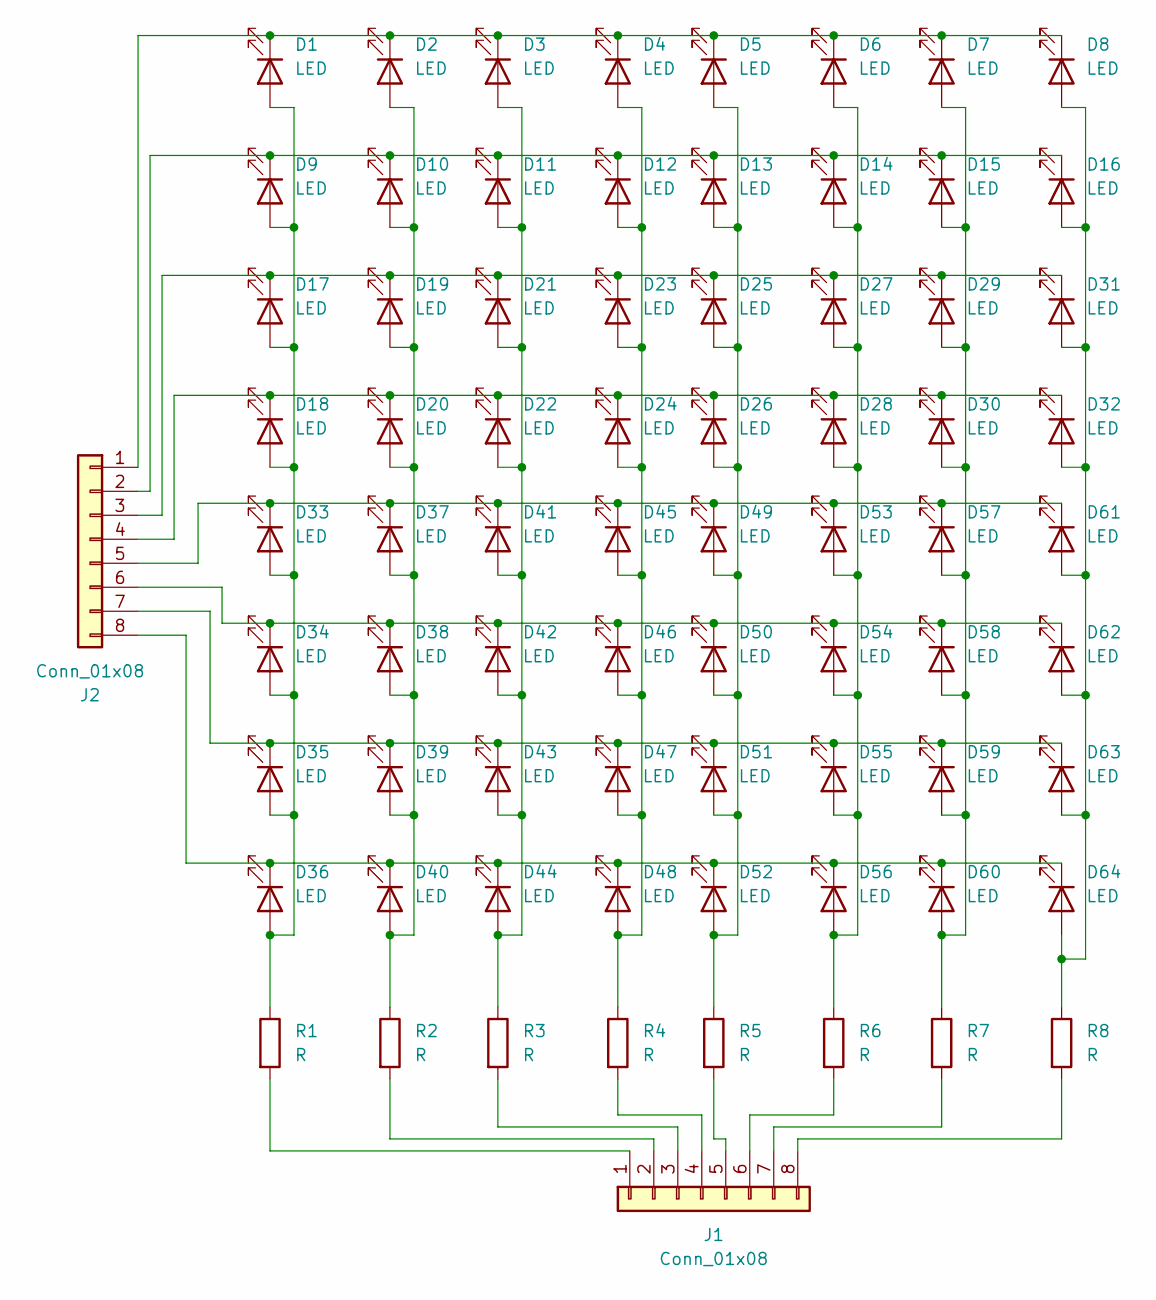
[picture p14: schematic ledki8x8.kicad_sch]

Parts:
D1, D2, D3, D4, D5, D6, D7, D8, D9, D10, D11, D12, D13, D14, D15, D16, D17, D18, D19, D20, D21, D22, D23, D24, D25, D26, D27, D28, D29, D30, D31, D32, D33, D34, D35, D36, D37, D38, D39, D40, D41, D42, D43, D44, D45, D46, D47, D48, D49, D50, D51, D52, D53, D54, D55, D56, D57, D58, D59, D60, D61, D62, D63, D64: LED; LED_0805_2012Metric
J1, J2: Conn_01x08; PinHeader_1x08_P2.54mm_Vertical
R1, R2, R3, R4, R5, R6, R7, R8: R; R_0805_2012Metric

Connections:
unnamed: D1.2 (A), D9.2 (A), D17.2 (A), D18.2 (A), D33.2 (A), D34.2 (A), D35.2 (A), D36.2 (A), R1.1
unnamed: D1.1 (K), D2.1 (K), D3.1 (K), D4.1 (K), D5.1 (K), D6.1 (K), D7.1 (K), D8.1 (K), J2.1
unnamed: D2.2 (A), D10.2 (A), D19.2 (A), D20.2 (A), D37.2 (A), D38.2 (A), D39.2 (A), D40.2 (A), R2.1
unnamed: D9.1 (K), D10.1 (K), D11.1 (K), D12.1 (K), D13.1 (K), D14.1 (K), D15.1 (K), D16.1 (K), J2.2
unnamed: D3.2 (A), D11.2 (A), D21.2 (A), D22.2 (A), D41.2 (A), D42.2 (A), D43.2 (A), D44.2 (A), R3.1
unnamed: D4.2 (A), D12.2 (A), D23.2 (A), D24.2 (A), D45.2 (A), D46.2 (A), D47.2 (A), D48.2 (A), R4.1
unnamed: D5.2 (A), D13.2 (A), D25.2 (A), D26.2 (A), D49.2 (A), D50.2 (A), D51.2 (A), D52.2 (A), R5.1
unnamed: D6.2 (A), D14.2 (A), D27.2 (A), D28.2 (A), D53.2 (A), D54.2 (A), D55.2 (A), D56.2 (A), R6.1
unnamed: D7.2 (A), D15.2 (A), D29.2 (A), D30.2 (A), D57.2 (A), D58.2 (A), D59.2 (A), D60.2 (A), R7.1
unnamed: D8.2 (A), D16.2 (A), D31.2 (A), D32.2 (A), D61.2 (A), D62.2 (A), D63.2 (A), D64.2 (A), R8.1
unnamed: D17.1 (K), D19.1 (K), D21.1 (K), D23.1 (K), D25.1 (K), D27.1 (K), D29.1 (K), D31.1 (K), J2.3
unnamed: D18.1 (K), D20.1 (K), D22.1 (K), D24.1 (K), D26.1 (K), D28.1 (K), D30.1 (K), D32.1 (K), J2.4
unnamed: D33.1 (K), D37.1 (K), D41.1 (K), D45.1 (K), D49.1 (K), D53.1 (K), D57.1 (K), D61.1 (K), J2.5
unnamed: D34.1 (K), D38.1 (K), D42.1 (K), D46.1 (K), D50.1 (K), D54.1 (K), D58.1 (K), D62.1 (K), J2.6
unnamed: D35.1 (K), D39.1 (K), D43.1 (K), D47.1 (K), D51.1 (K), D55.1 (K), D59.1 (K), D63.1 (K), J2.7
unnamed: D36.1 (K), D40.1 (K), D44.1 (K), D48.1 (K), D52.1 (K), D56.1 (K), D60.1 (K), D64.1 (K), J2.8
unnamed: J1.1, R1.2
unnamed: J1.2, R2.2
unnamed: J1.3, R3.2
unnamed: J1.4, R4.2
unnamed: J1.5, R5.2
unnamed: J1.6, R6.2
unnamed: J1.7, R7.2
unnamed: J1.8, R8.2

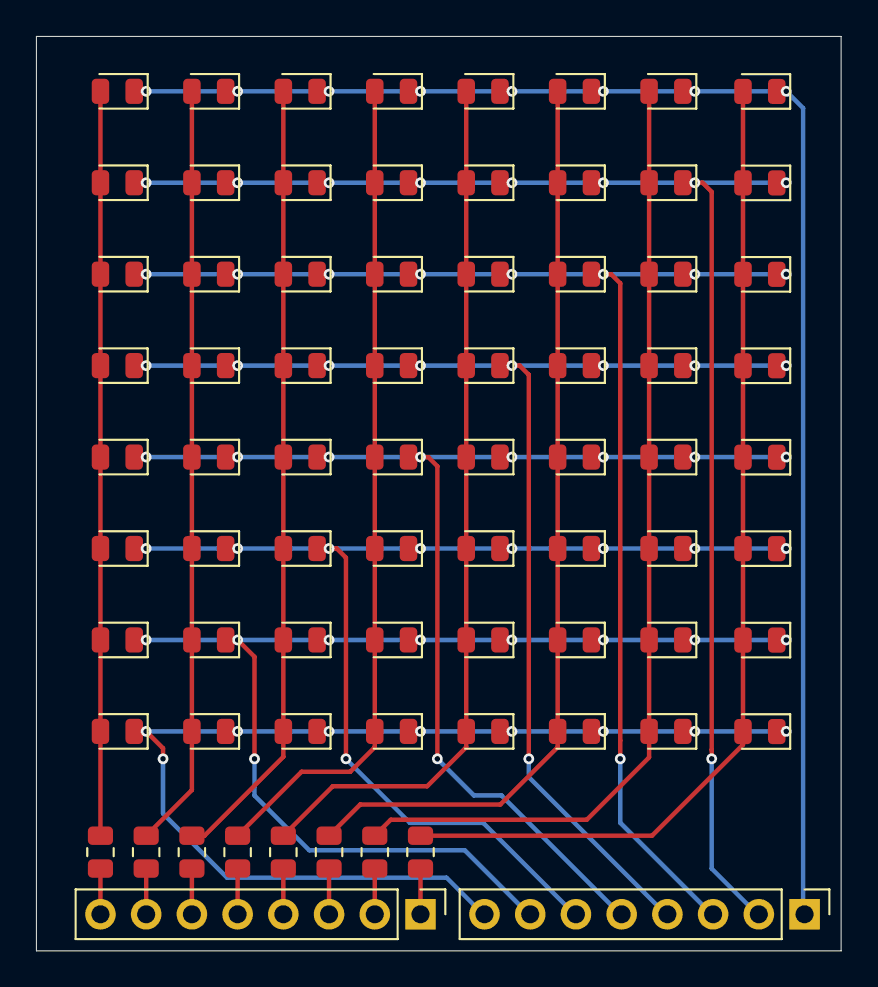
[picture p15: board ledki8x8.kicad_pcb from above]

Board: 2 copper layers, 44.7 x 50.8 mm, 74 parts (0 on the bottom side), 24 nets.
