JamPsym/letki/hw/ledkiv3/ledkiv3.kicad_pcb

## KiCad design hw/ledkiv3/ledkiv3.kicad_pcb (2025-10-16, an earlier design)

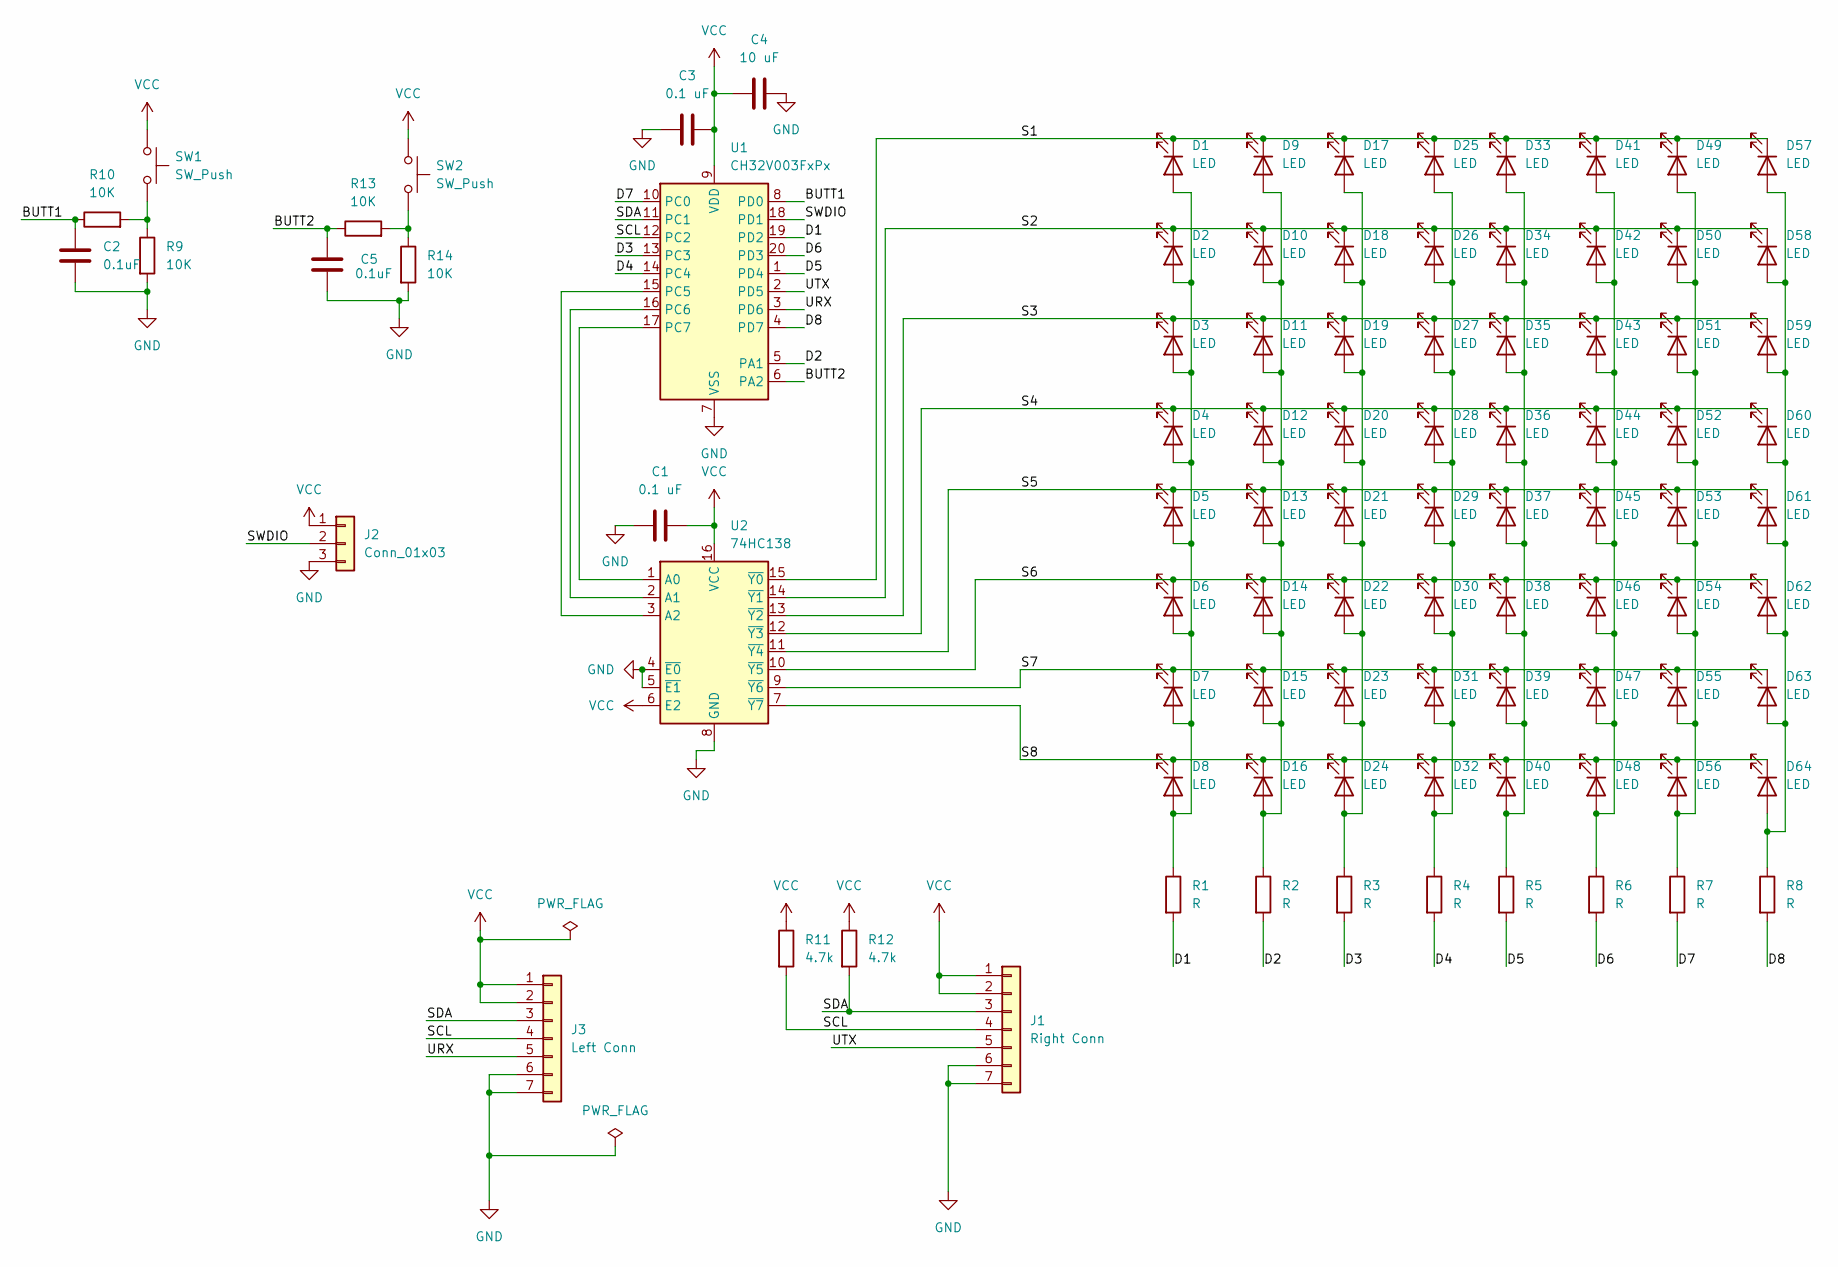
[picture p16: schematic ledkiv3.kicad_sch]

Parts:
C1, C3: 0.1 uF; C_0805_2012Metric_Pad1.18x1.45mm_HandSolder
C2, C5: 0.1uF; C_0805_2012Metric_Pad1.18x1.45mm_HandSolder
C4: 10 uF; C_0805_2012Metric_Pad1.18x1.45mm_HandSolder
D1, D2, D3, D4, D5, D6, D7, D8, D9, D10, D11, D12, D13, D14, D15, D16, D17, D18, D19, D20, D21, D22, D23, D24, D25, D26, D27, D28, D29, D30, D31, D32, D33, D34, D35, D36, D37, D38, D39, D40, D41, D42, D43, D44, D45, D46, D47, D48, D49, D50, D51, D52, D53, D54, D55, D56, D57, D58, D59, D60, D61, D62, D63, D64: LED; LED_0805_2012Metric
J1: Right Conn; PinHeader_1x07_P2.54mm_Vertical
J2: Conn_01x03; PinHeader_1x03_P2.54mm_Vertical
J3: Left Conn; PinHeader_1x07_P2.54mm_Vertical
R1, R2, R3, R4, R5, R6, R7, R8: R; R_0805_2012Metric_Pad1.20x1.40mm_HandSolder
R9, R10, R13, R14: 10K; R_0805_2012Metric_Pad1.20x1.40mm_HandSolder
R11, R12: 4.7k; R_0805_2012Metric_Pad1.20x1.40mm_HandSolder
SW1, SW2: SW_Push; SW_tactile_TS-1089S
U1: CH32V003FxPx; TSSOP-20_4.4x6.5mm_P0.65mm
U2: 74HC138; TSSOP-16_4.4x5mm_P0.65mm

Connections:
/BUTT1: C2.1, R10.1, U1.8 (PD0)
/BUTT2: C5.1, R13.1, U1.6 (PA2)
/D1: R1.2, U1.19 (PD2)
/D2: R2.2, U1.5 (PA1)
/D3: R3.2, U1.13 (PC3)
/D4: R4.2, U1.14 (PC4)
/D5: R5.2, U1.1 (PD4)
/D6: R6.2, U1.20 (PD3)
/D7: R7.2, U1.10 (PC0)
/D8: R8.2, U1.4 (PD7)
/S1: D1.1 (K), D9.1 (K), D17.1 (K), D25.1 (K), D33.1 (K), D41.1 (K), D49.1 (K), D57.1 (K), U2.15 (~Y0)
/S2: D2.1 (K), D10.1 (K), D18.1 (K), D26.1 (K), D34.1 (K), D42.1 (K), D50.1 (K), D58.1 (K), U2.14 (~Y1)
/S3: D3.1 (K), D11.1 (K), D19.1 (K), D27.1 (K), D35.1 (K), D43.1 (K), D51.1 (K), D59.1 (K), U2.13 (~Y2)
/S4: D4.1 (K), D12.1 (K), D20.1 (K), D28.1 (K), D36.1 (K), D44.1 (K), D52.1 (K), D60.1 (K), U2.12 (~Y3)
/S5: D5.1 (K), D13.1 (K), D21.1 (K), D29.1 (K), D37.1 (K), D45.1 (K), D53.1 (K), D61.1 (K), U2.11 (~Y4)
/S6: D6.1 (K), D14.1 (K), D22.1 (K), D30.1 (K), D38.1 (K), D46.1 (K), D54.1 (K), D62.1 (K), U2.10 (~Y5)
/S7: D7.1 (K), D15.1 (K), D23.1 (K), D31.1 (K), D39.1 (K), D47.1 (K), D55.1 (K), D63.1 (K), U2.9 (~Y6)
/S8: D8.1 (K), D16.1 (K), D24.1 (K), D32.1 (K), D40.1 (K), D48.1 (K), D56.1 (K), D64.1 (K), U2.7 (~Y7)
/SCL: J1.4, J3.4, R11.2, U1.12 (PC2)
/SDA: J1.3, J3.3, R12.2, U1.11 (PC1)
/SWDIO: J2.2, U1.18 (PD1)
/URX: J3.5, U1.3 (PD6)
/UTX: J1.5, U1.2 (PD5)
GND: C1.1, C2.2, C3.1, C4.2, C5.2, J1.6, J1.7, J2.3, J3.6, J3.7, R9.2, R14.2, U1.7 (VSS), U2.4 (~E0), U2.5 (~E1), U2.8 (GND)
unnamed: D1.2 (A), D2.2 (A), D3.2 (A), D4.2 (A), D5.2 (A), D6.2 (A), D7.2 (A), D8.2 (A), R1.1
unnamed: D9.2 (A), D10.2 (A), D11.2 (A), D12.2 (A), D13.2 (A), D14.2 (A), D15.2 (A), D16.2 (A), R2.1
unnamed: D17.2 (A), D18.2 (A), D19.2 (A), D20.2 (A), D21.2 (A), D22.2 (A), D23.2 (A), D24.2 (A), R3.1
unnamed: D25.2 (A), D26.2 (A), D27.2 (A), D28.2 (A), D29.2 (A), D30.2 (A), D31.2 (A), D32.2 (A), R4.1
unnamed: D33.2 (A), D34.2 (A), D35.2 (A), D36.2 (A), D37.2 (A), D38.2 (A), D39.2 (A), D40.2 (A), R5.1
unnamed: D41.2 (A), D42.2 (A), D43.2 (A), D44.2 (A), D45.2 (A), D46.2 (A), D47.2 (A), D48.2 (A), R6.1
unnamed: D49.2 (A), D50.2 (A), D51.2 (A), D52.2 (A), D53.2 (A), D54.2 (A), D55.2 (A), D56.2 (A), R7.1
unnamed: D57.2 (A), D58.2 (A), D59.2 (A), D60.2 (A), D61.2 (A), D62.2 (A), D63.2 (A), D64.2 (A), R8.1
unnamed: R9.1, R10.2, SW1.2
unnamed: R13.2, R14.1, SW2.2
unnamed: U1.15 (PC5), U2.3 (A2)
unnamed: U1.16 (PC6), U2.2 (A1)
unnamed: U1.17 (PC7), U2.1 (A0)
VCC: C1.2, C3.2, C4.1, J1.1, J1.2, J2.1, J3.1, J3.2, R11.1, R12.1, SW1.1, SW2.1, U1.9 (VDD), U2.6 (E2), U2.16 (VCC)

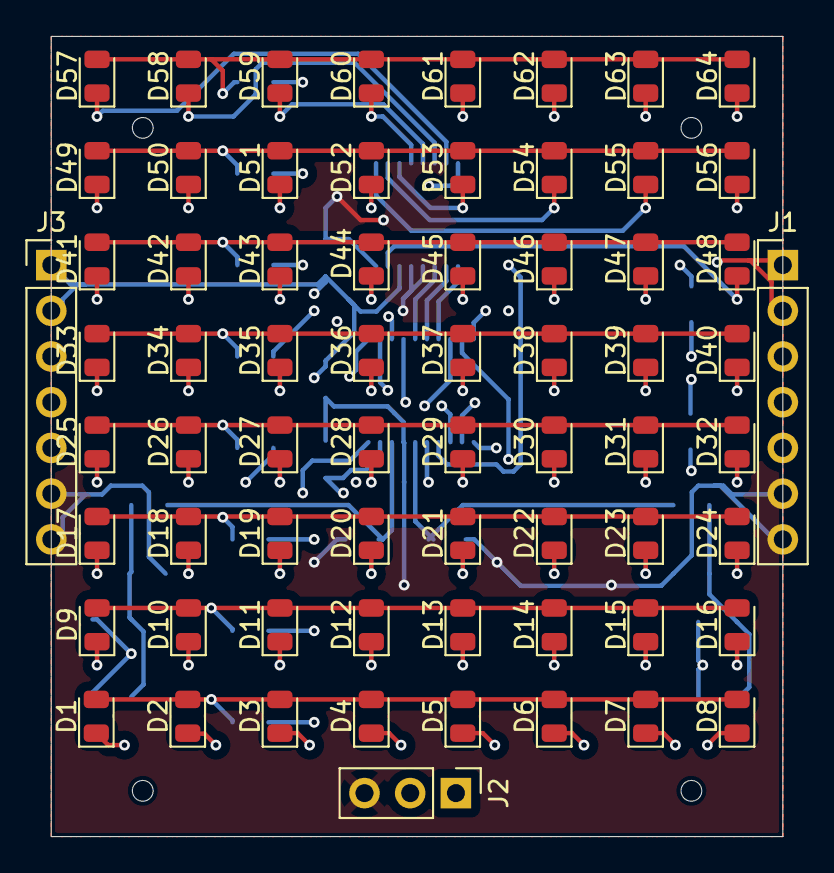
[picture p17: board ledkiv3.kicad_pcb from above]

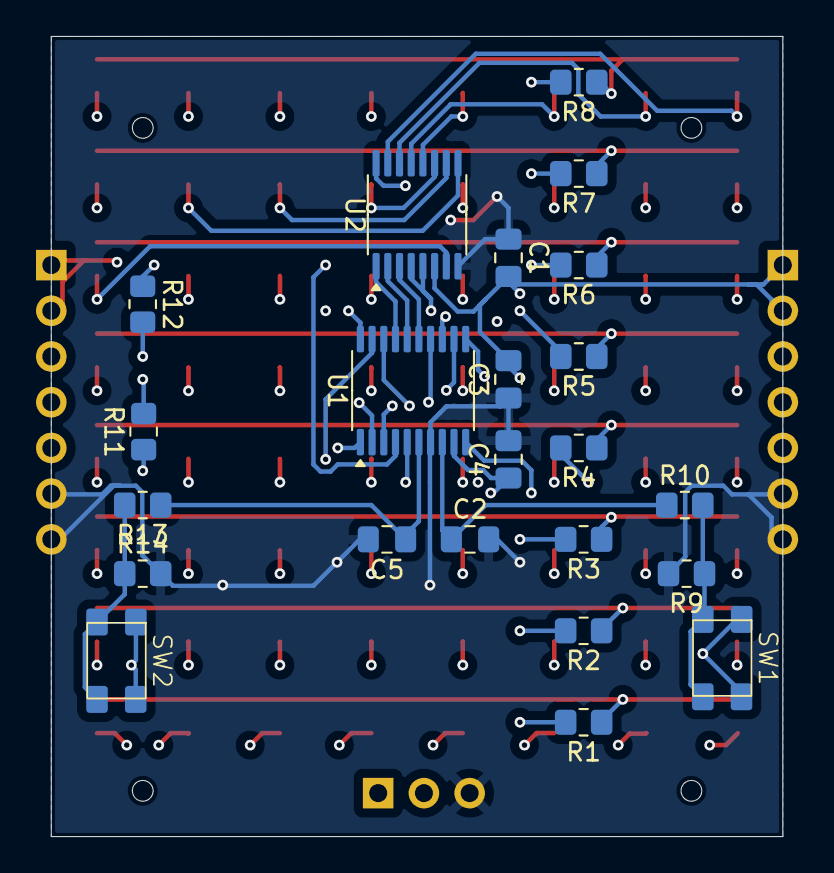
[picture p18: board ledkiv3.kicad_pcb from below]

Board: 4 copper layers, 40.6 x 44.4 mm, 90 parts (23 on the bottom side), 38 nets.
