JamPsym/letki/(commit log)

2025-10-11 Initial PWM configuration for matrix display
2025-10-16 Reorganize project layout and clean artifacts
    [ledki8x8-B_Cu.gbr, ledki8x8-B_Mask.gbr, ledki8x8-B_Paste.gbr, ledki8x8-B_Silkscreen.gbr, ledki8x8-Edge_Cuts.gbr, ledki8x8-F_Cu.gbr, ledki8x8-F_Mask.gbr, ledki8x8-F_Paste.gbr]
2025-10-16 clean up kicad files
    [ledki8x8-B_Cu.gbr, ledki8x8-B_Mask.gbr, ledki8x8-B_Paste.gbr, ledki8x8-B_Silkscreen.gbr, ledki8x8-Edge_Cuts.gbr, ledki8x8-F_Cu.gbr, ledki8x8-F_Mask.gbr, ledki8x8-F_Paste.gbr]
2026-10-18 Preserve Letki development baseline and organize repository
    Record the accumulated firmware, native host applications, tests, CAD sources,
    configuration, milestone manifests and dated development notes after the old
    single-board layout. Keep original firmware and hardware in source archives.
    Replace the chronological root README with a current project overview, retain
    its full history in docs, and add navigation and repository/data setup guides.
    Clarify that the media host is the last planned system component and development
    continues. Preserve CAD and shared inventory; ignore generated artifacts and
    machine-local inventory links while retaining hardware baseline metadata.
    Validation: all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
